stinger000/RaceMini_docs/docs/index.md

# Сборка гоночного дрона COEX Race Mini

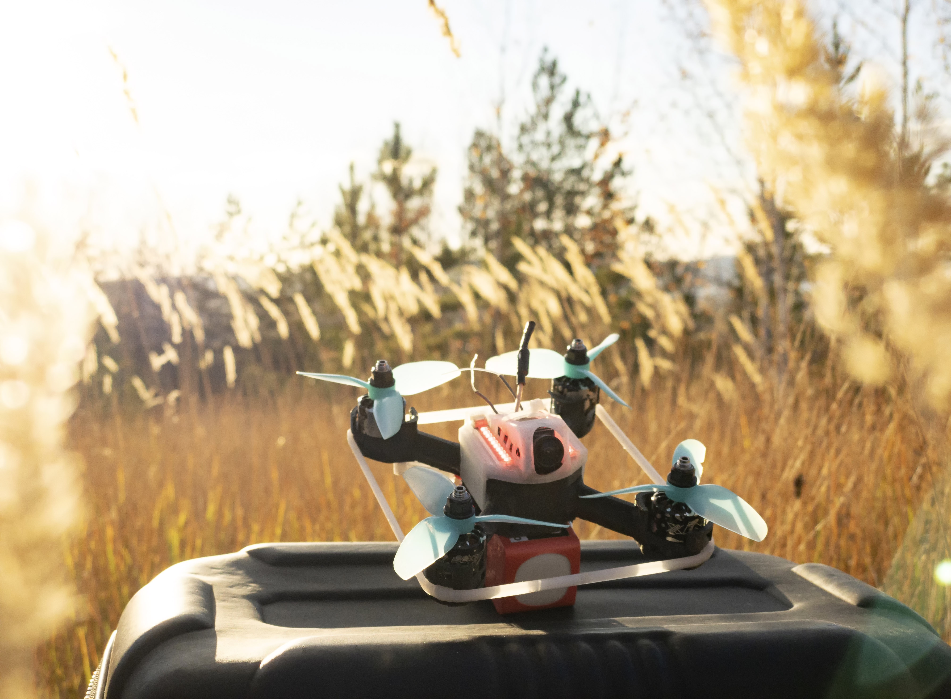
[picture p1: docs/img/drone.jpg]


COEX Race Mini - дрон который предназначен для гонок! При помощи него вы с легкостью освоите спортивное пилотирование.
Тренируйтесь и побеждайте! Увидимся на соревнованиях

## Комплект поставки
Внешний вид коробки:
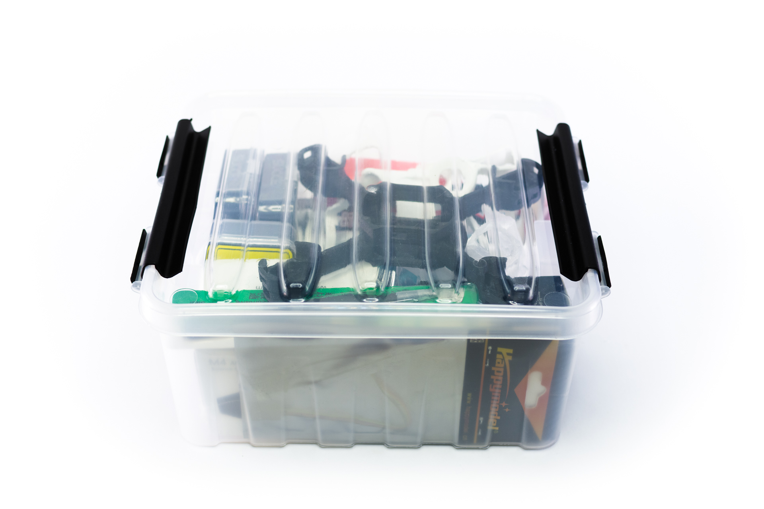
[picture p2: docs/img/box.jpg]

Содержимое:
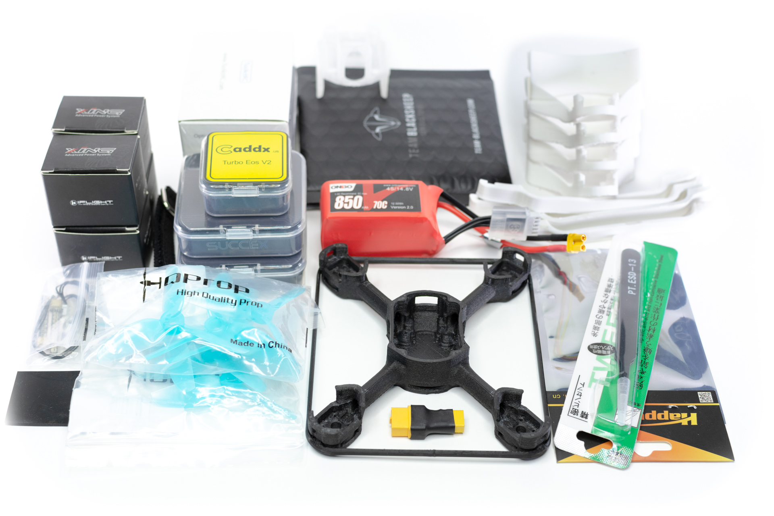
[picture p3: docs/img/box_content.jpg]


## Установка моторов
Установите ребро жесткости на раму, как это показано на видео:
<video src="video/hack.mp4" controls width="100%" ></video>
Изначально моторы поставляются с проводами одинаковой длины и гайками правого вращения:
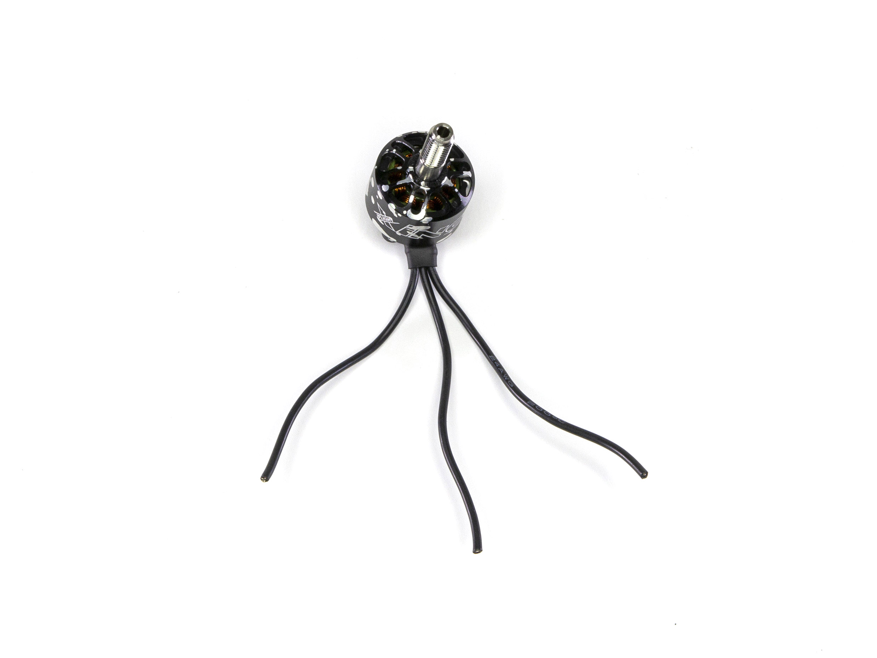
[picture p4: docs/img/motor.jpg]

Два мотора (они будут вращаться по часовой стрелке) обрежьте как показано на рисунке: нижний провод должен быть длиной 60 миллиметров, обозначим его буквой <span style="color:lime">А</span>; средний провод должен быть длиной 65 миллиметров, обозначим его буквой <span style="color:blue">В</span>; верхний провод должен быть длиной 70 миллиметров, обозначим его буквой <span style="color:red">С</span>.
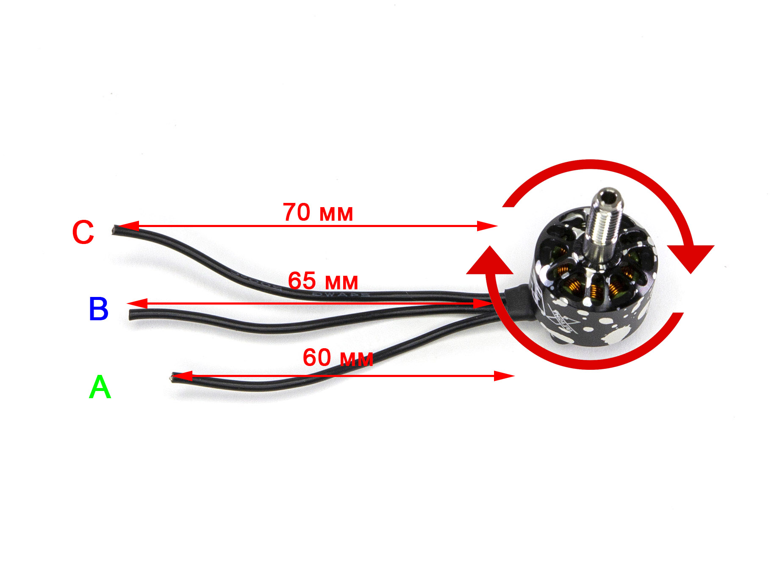
[picture p5: docs/img/motor_cut_cw.jpg]

Другие два мотора (они будут вращаться против часовой стрелки) обрежьте как показано на другом рисунке:
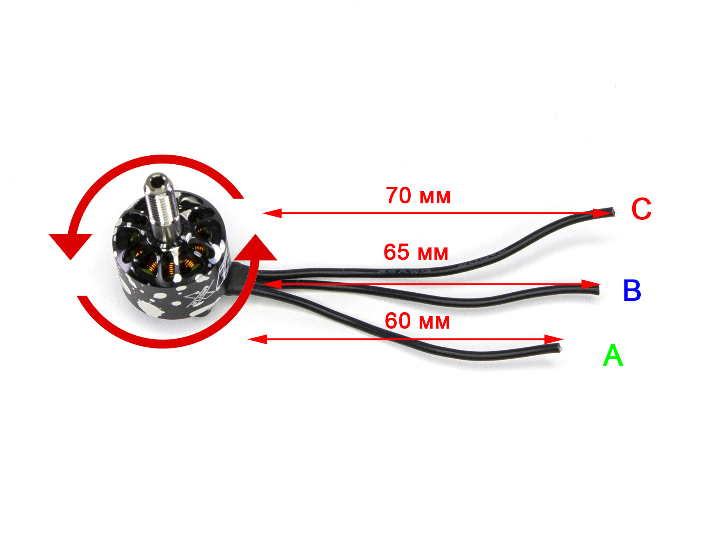
[picture p6: docs/img/motor_cut_ccw.jpg]

Снимите 3 миллиметра изоляции с каждого провода и залудите их. Расположение моторов на дроне будет следующим: моторы, вращающиеся против часовой стрелки находятся на местах 1 и 4, моторы, вращающиеся по часовой стрелке располагаются на местах 2 и 3. На данном рисунке направление переда рамы обозначено стрелкой.
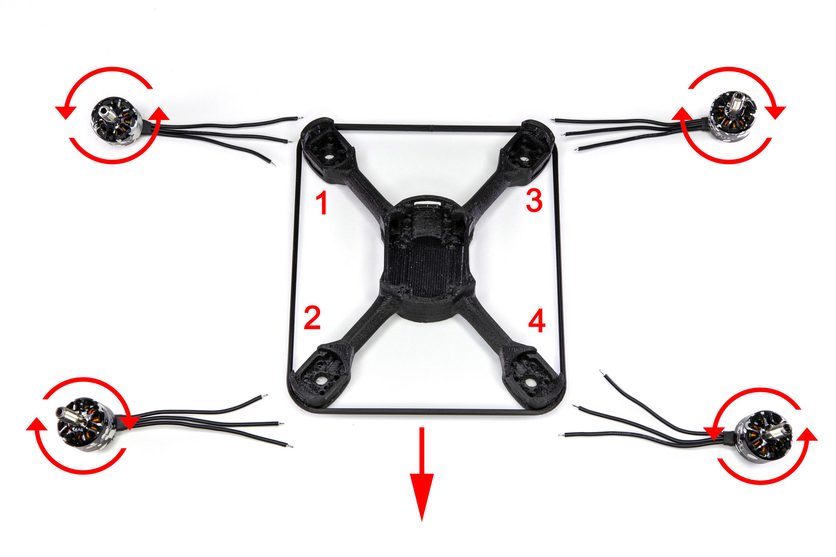
[picture p7: docs/img/motors_tined.jpg]

Установите моторы на места и закрепите с обратной стороны рамы, используя винты М2 из набора моторов:
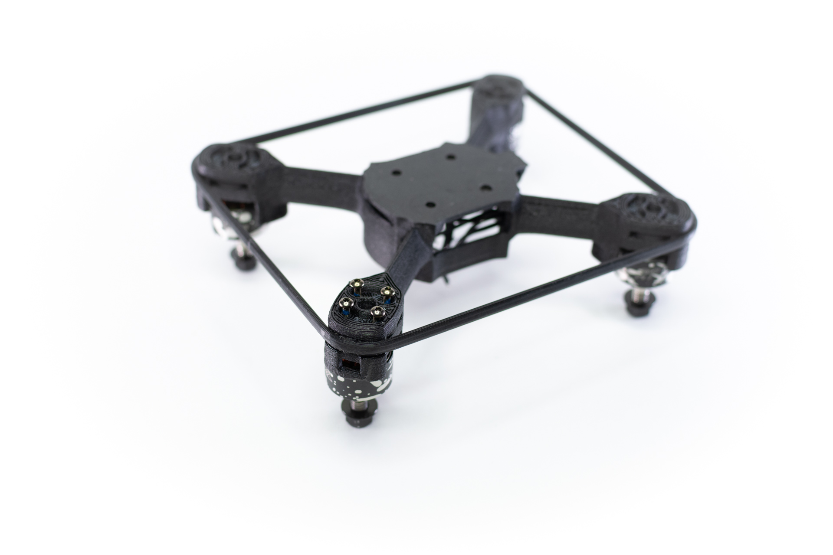
[picture p8: docs/img/motors_bolts.jpg]

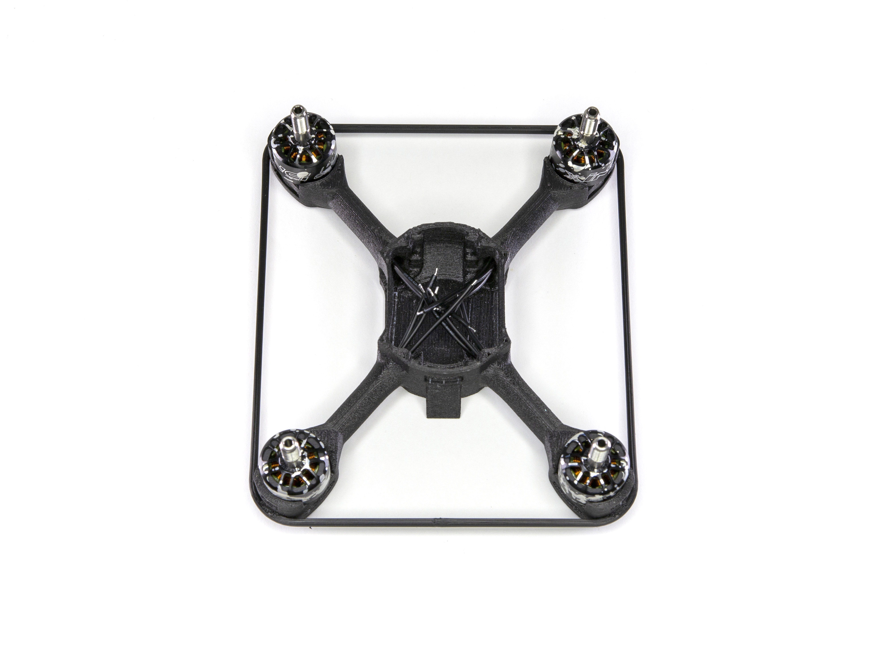
[picture p9: docs/img/motors_mounted.jpg]


## Установка ESC
Внешний вид ESC и кабеля питания:
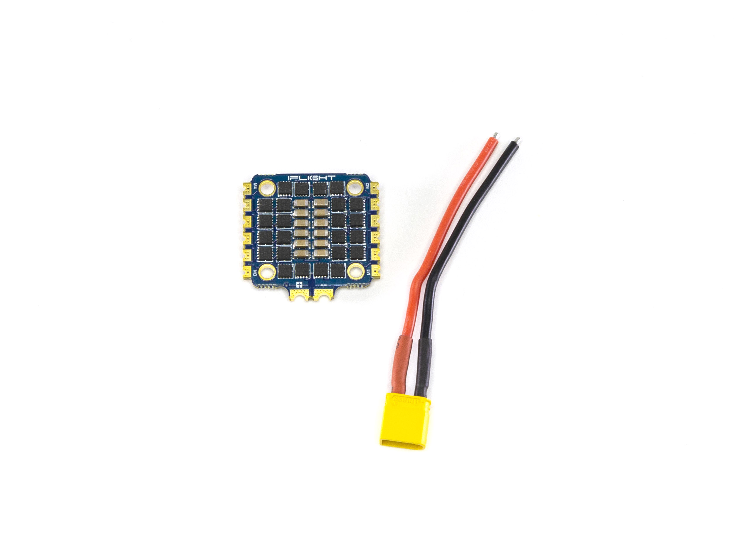
[picture p10: docs/img/esc.jpg]

Обрежьте кабель питания до длины в 20 миллиметров:
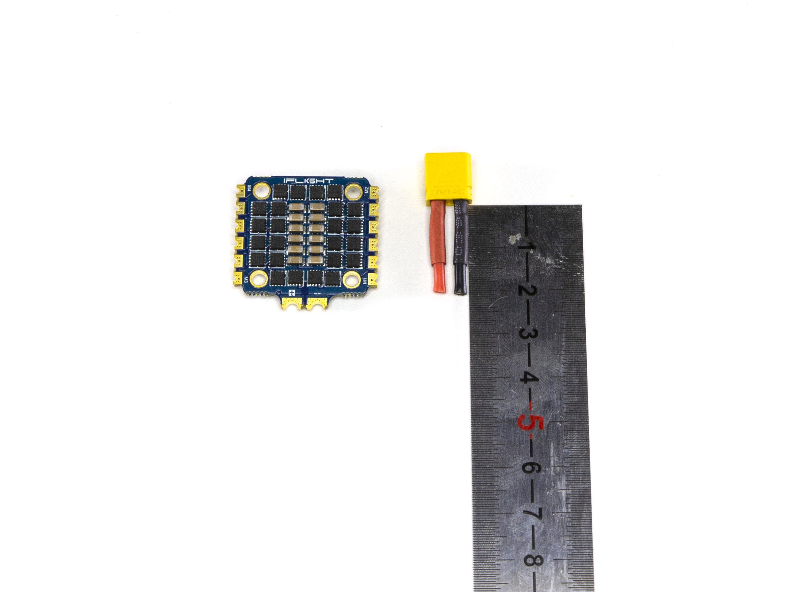
[picture p11: docs/img/esc_cut.jpg]

Снимите три миллиметра изоляции и залудите провода:
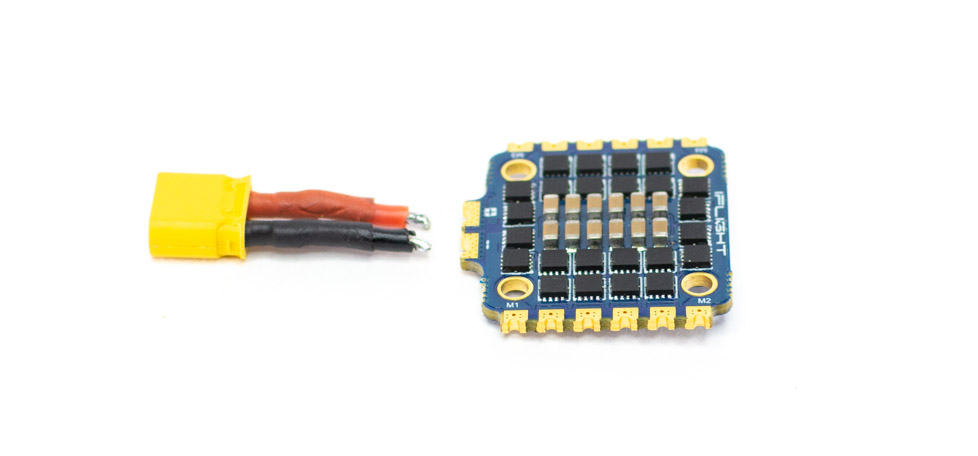
[picture p12: docs/img/esc_tined.jpg]

 Припаяйте их к плате, соблюдая полярность: красный провод необходимо подключить к контакту, обозначенному знаком +, а черный - к контакту, обозначенному знаком - :
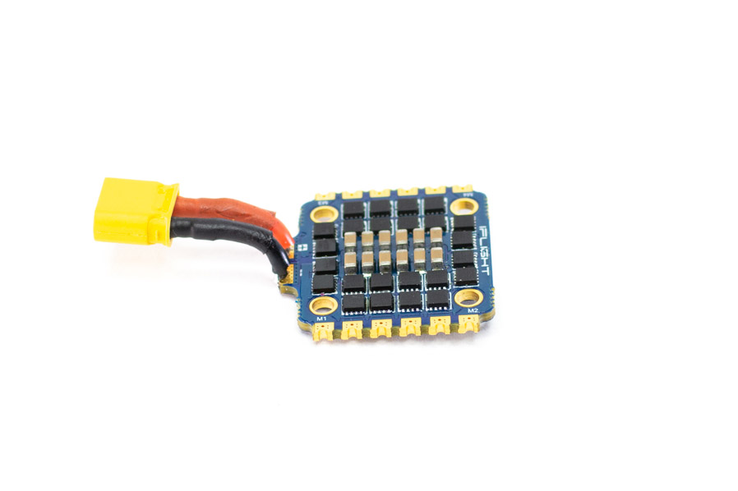
[picture p13: docs/img/esc_soldered.jpg]

Установите силиконовые проставки в отверстия:
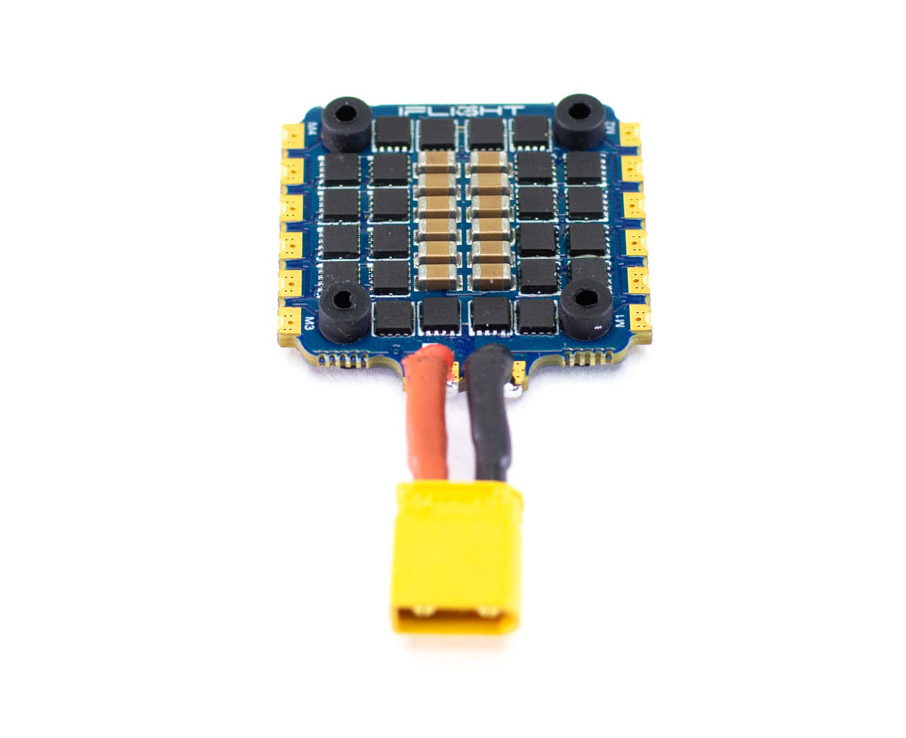
[picture p14: docs/img/esc_orings.jpg]

Более длинная часть должна быть направлена вверх:
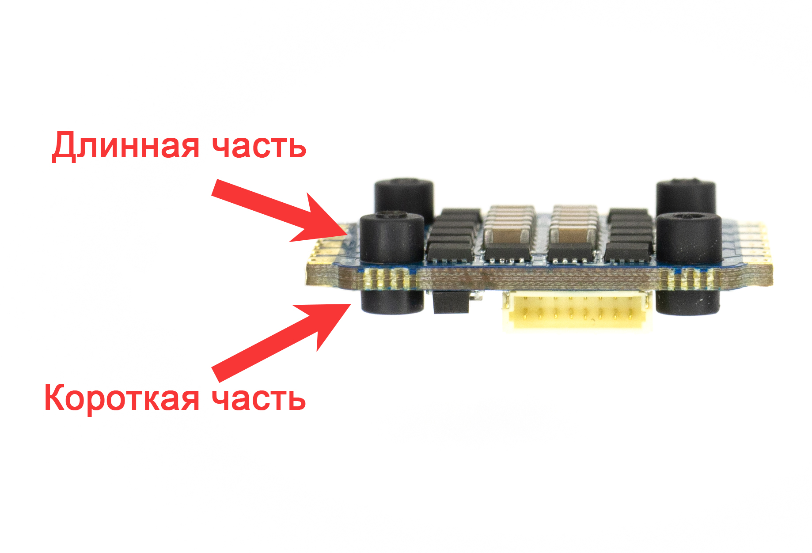
[picture p15: docs/img/esc_orings_pos.jpg]

Вставьте шлейф в плату регуляторов:
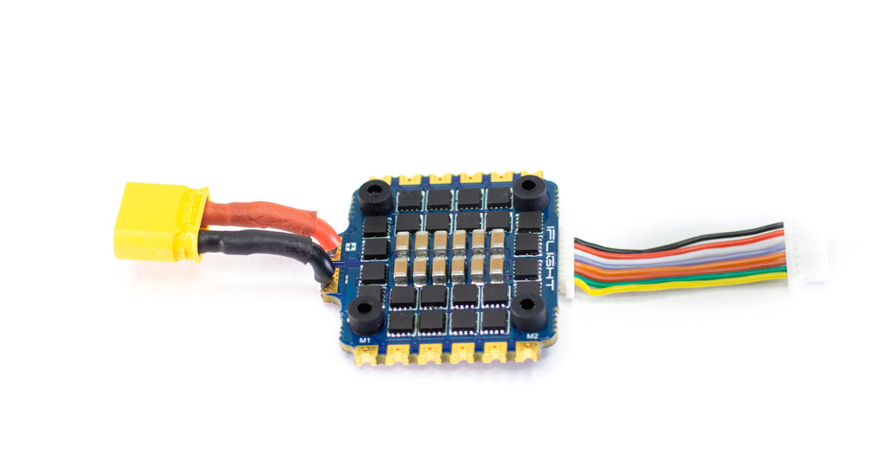
[picture p16: docs/img/esc_cable.jpg]

Установите плату регуляторов со шлейфом в корпус, закрутите винтами М2x20 с обратной стороны.
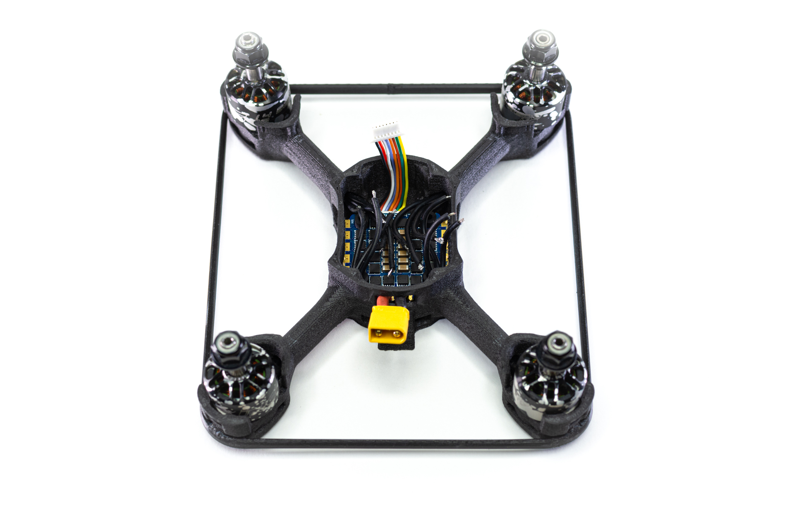
[picture p17: docs/img/esc_placed.jpg]

Припаяйте выводы моторов к контактным площадкам: на рисунке ниже буква
 <span style="color:lime">А</span>
 соответствует короткому проводу, буква
 <span style="color:blue">В</span> -
 среднему, а буква
 <span style="color:red">С</span> -
 длинному проводу.
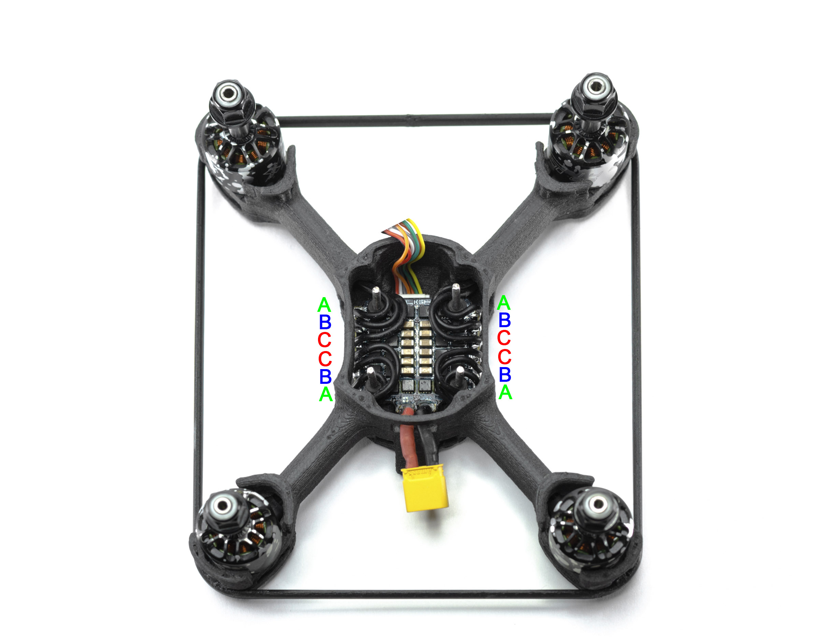
[picture p18: docs/img/esc_motors.jpg]

Вид сбоку:
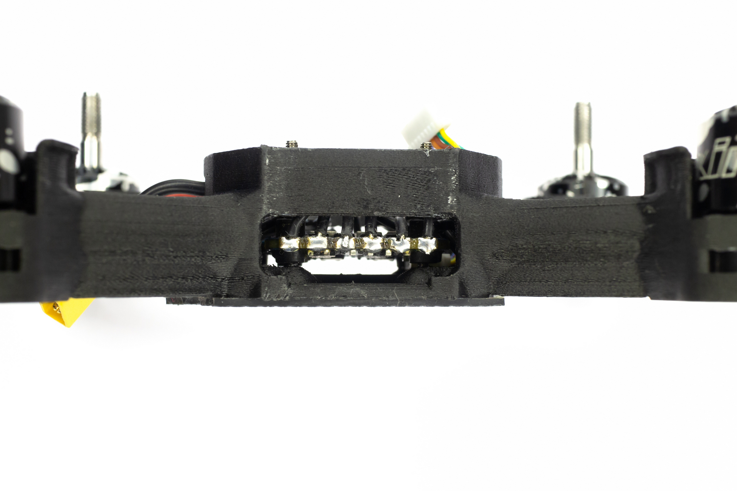
[picture p19: docs/img/esc_side.jpg]


## Установка полетного контроллера

Внешний вид полетного контроллера:
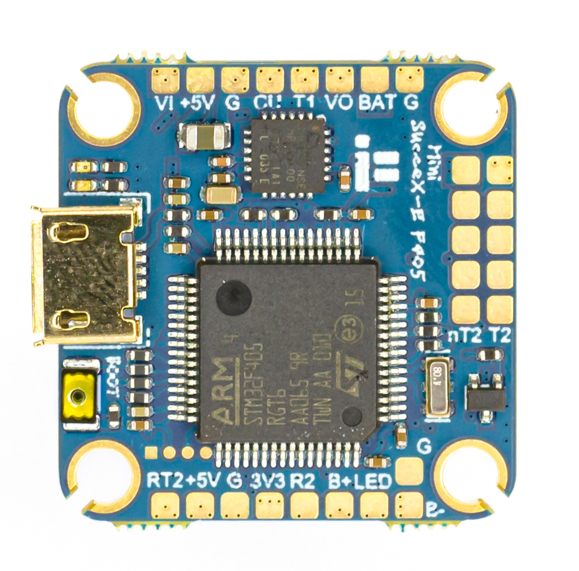
[picture p20: docs/img/fc.jpg]


### Подключение видеопередатчика
Для видеопередатчика IFlight воспользуйтесь данной инструкцией. Если в комплекте с дроном идет видеопередатчик Mamba, то 
шаги инструкции будут те же, но расположение выводов видеопередатчика будет отличаться:

<details>
  <summary>Подключение Mamba VTX</summary>
Данный видеопередатчик имеет следующее расположение выводов:
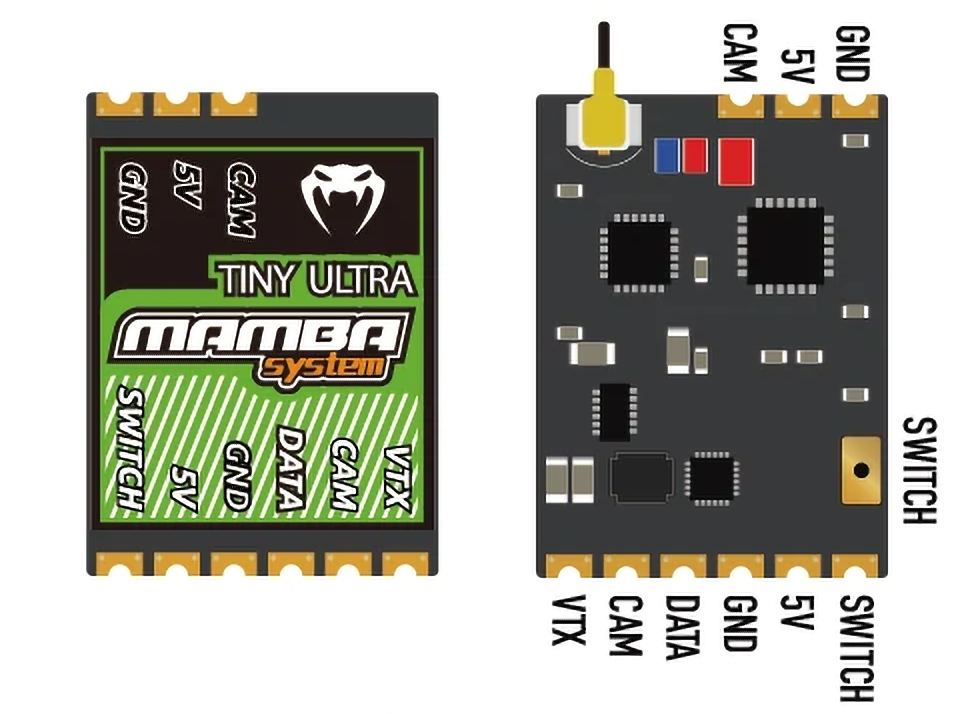
[picture p21: docs/img/vtx_mamba.png]
 
Он подключается в следующей последовательности:
   <table>
        <tr><th>VTX</th><th>Полетный контроллер</th></tr>
        <tr>
             <td>
                  <font color=red>5V</font>
             </td>
             <td>5v</td>
        </tr>
        <tr>
             <td><font color=black>GND</font></td>
             <td>G</td>
        </tr>
        <tr>
             <td><font color=goldenrod>VTX</font></td>
             <td>VO</td>
        </tr>
        <tr>
             <td><font class="outlined">DATA</font> </td>
             <td>T1</td>
        </tr>
   </table>

</details>

Видеопередатчик находится внутри этой коробочки:
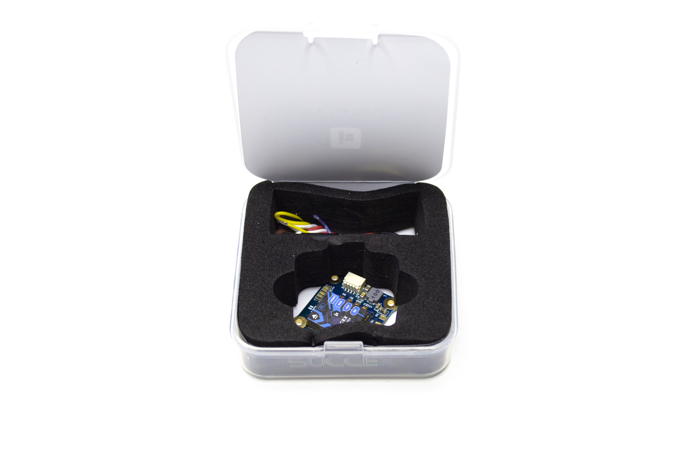
[picture p22: docs/img/vtx_pack.jpg]

Внутри находится сам видеопередатчик, адаптер для установки в отверстия 20х20 (он нам не понадобится), антенна, переходник для установки другой антенны (он также не понадобится) и провода:
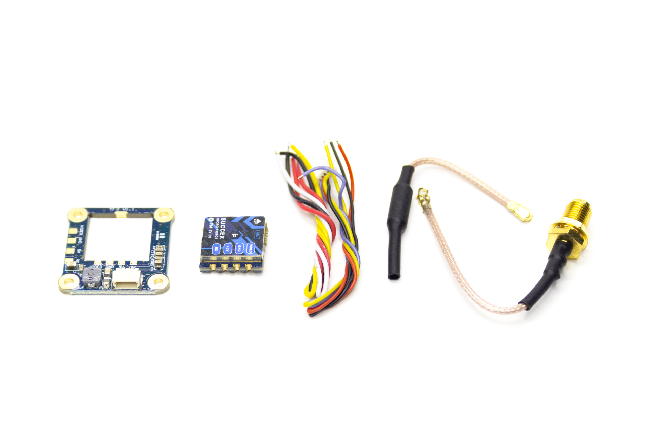
[picture p23: docs/img/vtx_pack_content.jpg]

На верхней стороне видеопередатчика находятся подписи контактных площадок:
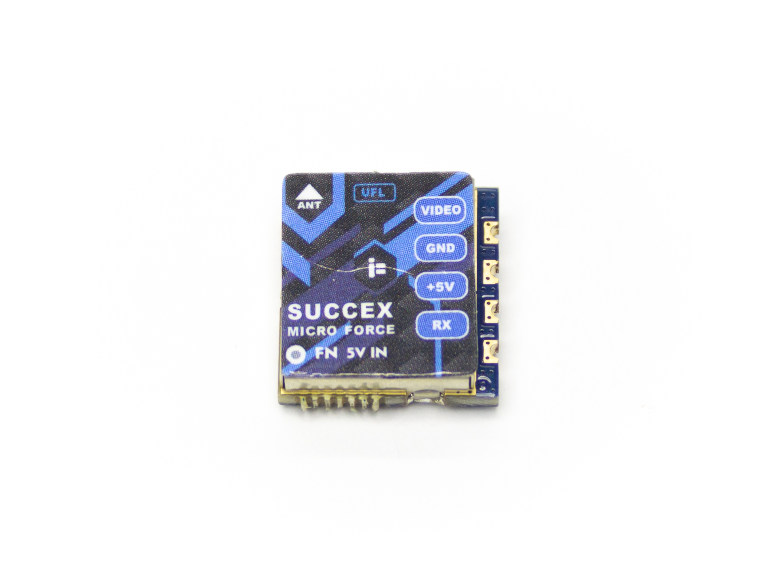
[picture p24: docs/img/vtx_top.jpg]

С другой стороны располагается разъем для антенны и кнопка переключения каналов:
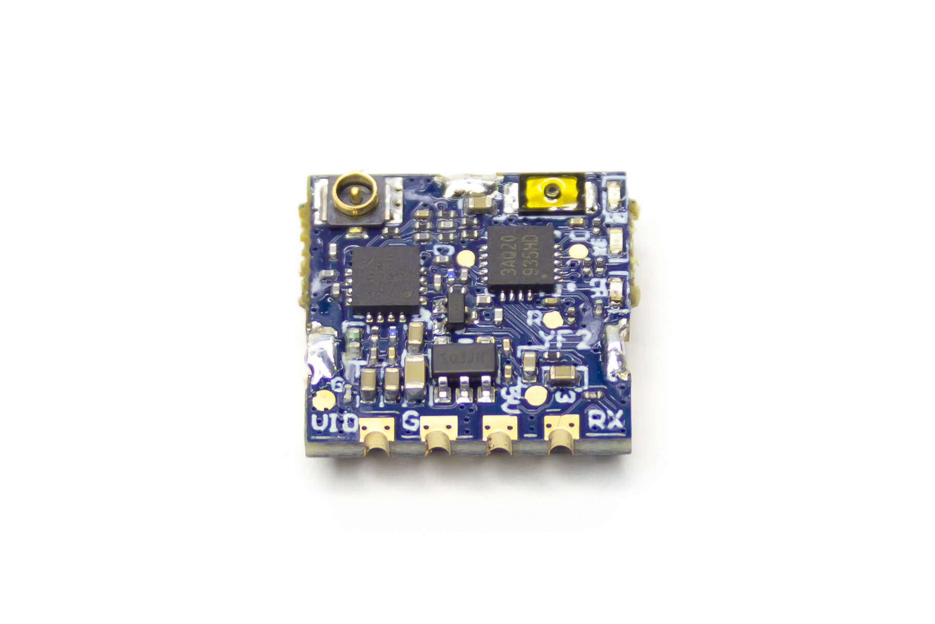
[picture p25: docs/img/vtx_bottom.jpg]

Припаяйте провода к видеопередатчику в следующей последовательности:
<span style="color:red">красный</span>
провод к контакту +5V, **черный** - к контакту GND,
<span style="color:goldenrod;">желтый</span> - к контакту VIDEO и
<span class="outlined">белый</span> - к контакту RX:
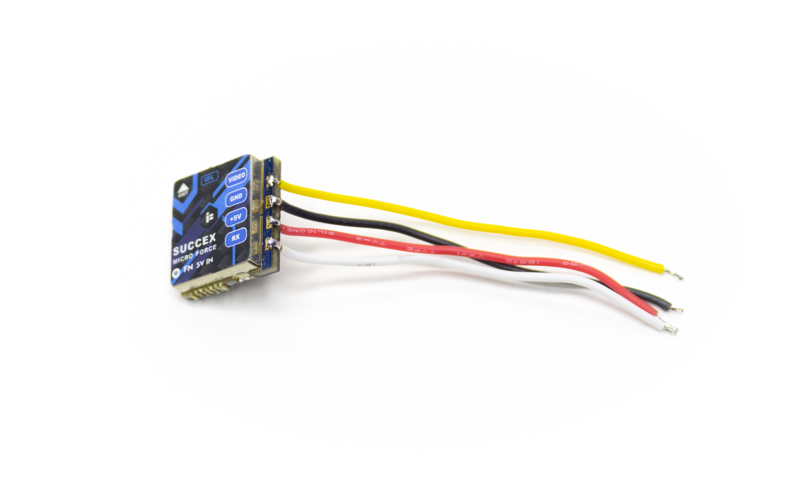
[picture p26: docs/img/vtx_cable.jpg]

Вставите антенну в видеопередатчик:
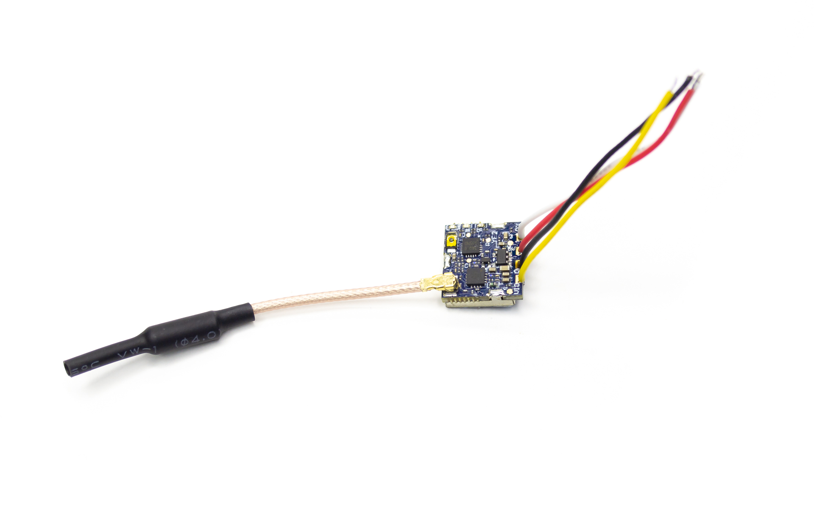
[picture p27: docs/img/vtx_antenna.jpg]

Наденьте термоусадку на видеопередатчик и усадите её потоком горячего воздуха:
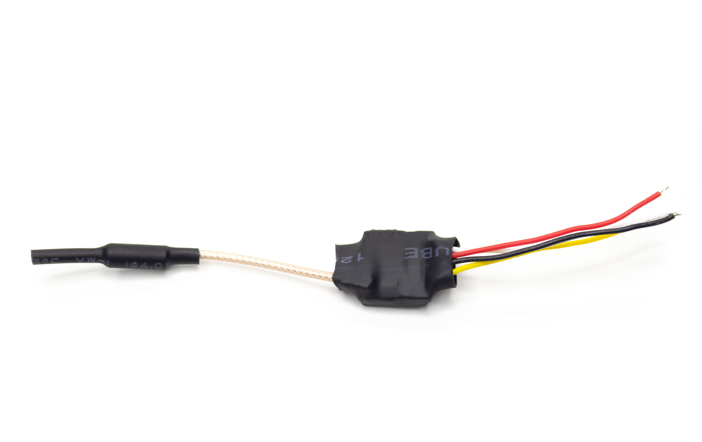
[picture p28: docs/img/vtx_heatshrink.jpg]

Обрежьте провода до длины в 60 миллиметров, залудите на 3 миллиметра и припаяйте провода к полетному контроллеру в следующей последовательности:
<span style="color:red">красный</span>
провод к контакту +5V, **черный** - к контакту G,
<span style="color:goldenrod;">желтый</span> - к контакту VO и
<span class="outlined">белый</span> - к контакту T1:
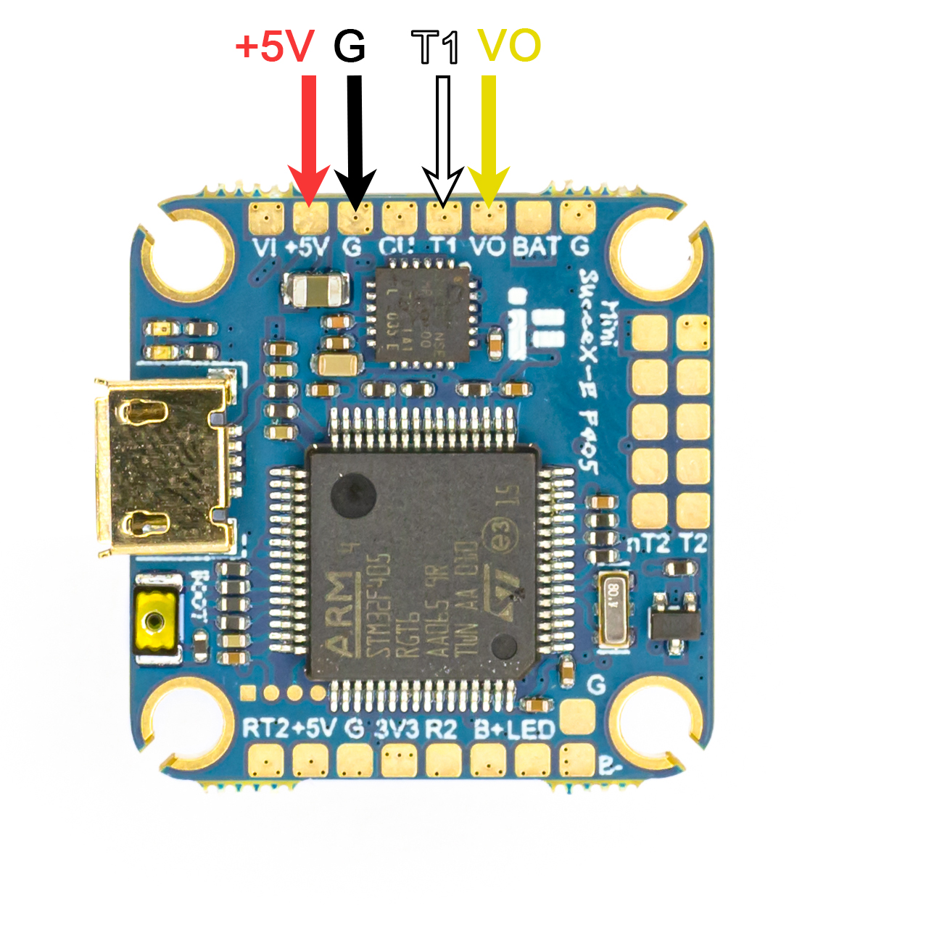
[picture p29: docs/img/vtx_pads.jpg]

Вот так это будет выглядеть:
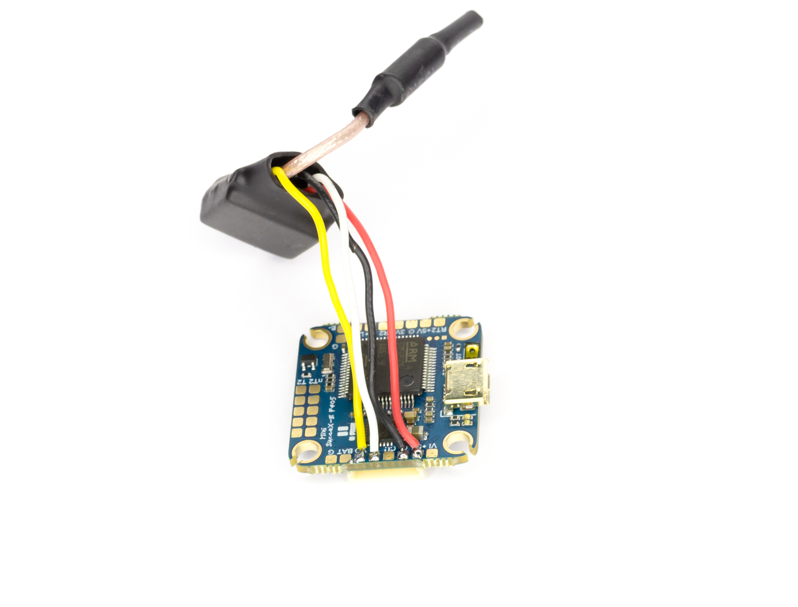
[picture p30: docs/img/vtx_soldered.jpg]


### Подключение камеры

Внешний вид камеры:
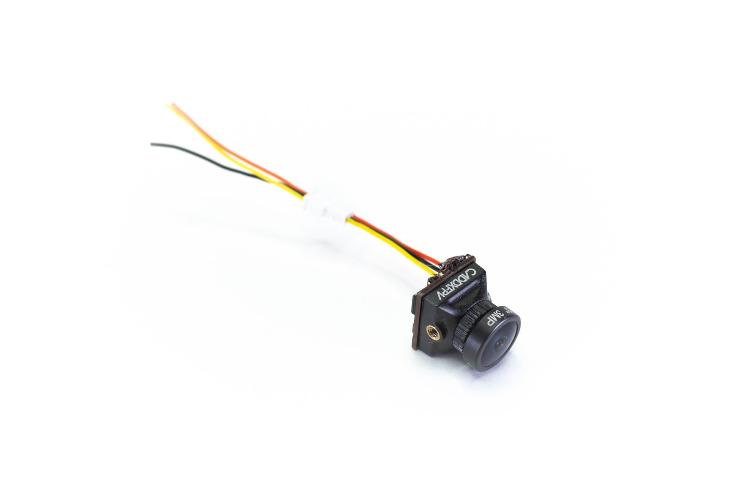
[picture p31: docs/img/cam.jpg]

Обрежьте ответный кабель разъема камеры на длину в 50 миллиметров, и залудите концы на длину в 3 миллиметра. Припаяйте его к полетному контроллеру в следующем порядке:
**черный** провод - к контакту G,
<span style="color:goldenrod;">желтый</span> - к контакту VI,
<span style="color:red">красный</span> - к контакту +5 вольт, как показано на схеме:
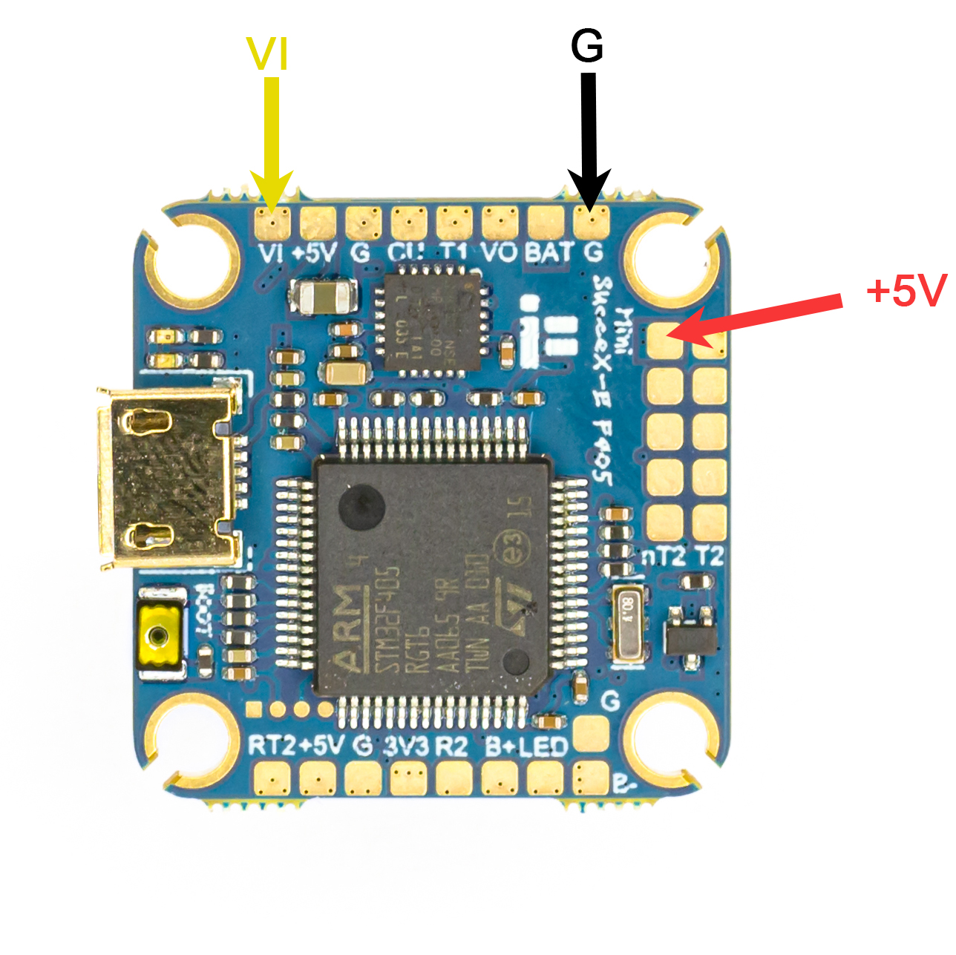
[picture p32: docs/img/cam_pads.jpg]

Припаянный провод должен выглядеть следующим образом:
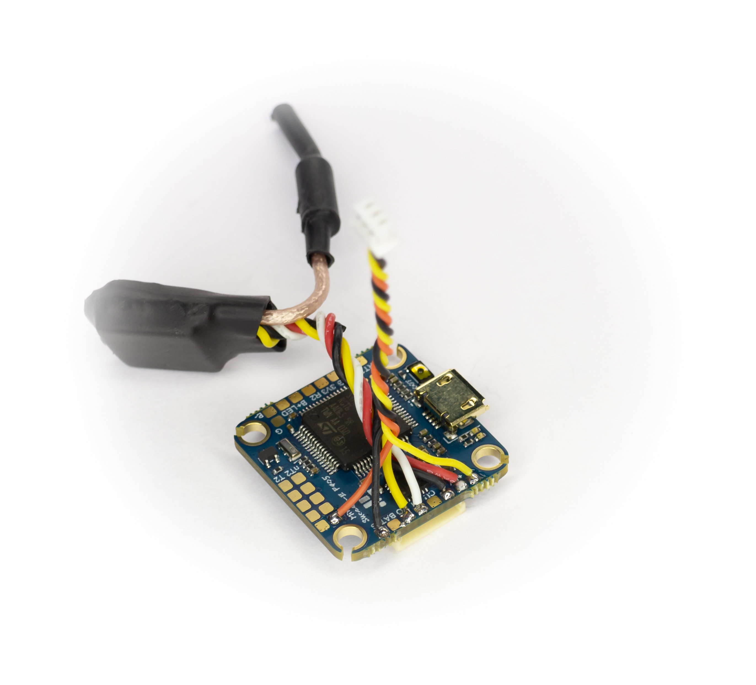
[picture p33: docs/img/cam_cable_soldered.jpg]


### Подключение светодиодной ленты

В комплекте со светодиодной лентой идет провод:
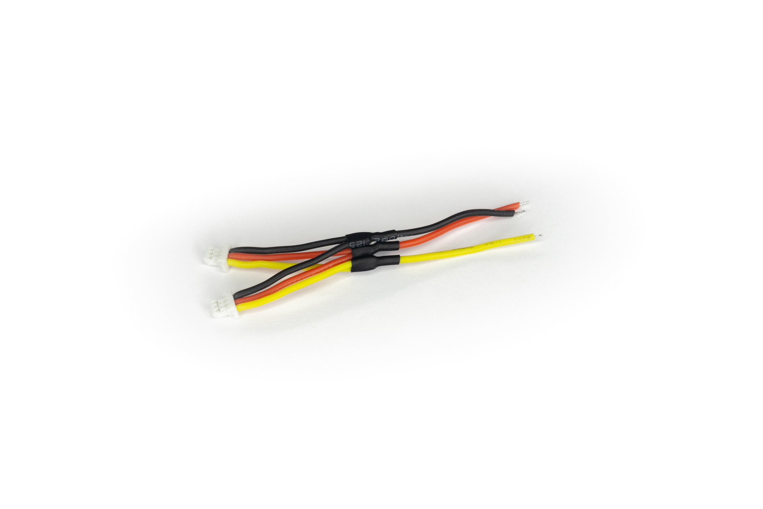
[picture p34: docs/img/led_cable.jpg]

Припаяйте провода к полетному контроллеру в следующей последовательности:
**G** к контакту G,
<span style="color:red">5v</span> к контакту B+ полетного контроллера, и
<span style="color:goldenrod;">sig</span> к контакту LED, как показано на схеме:
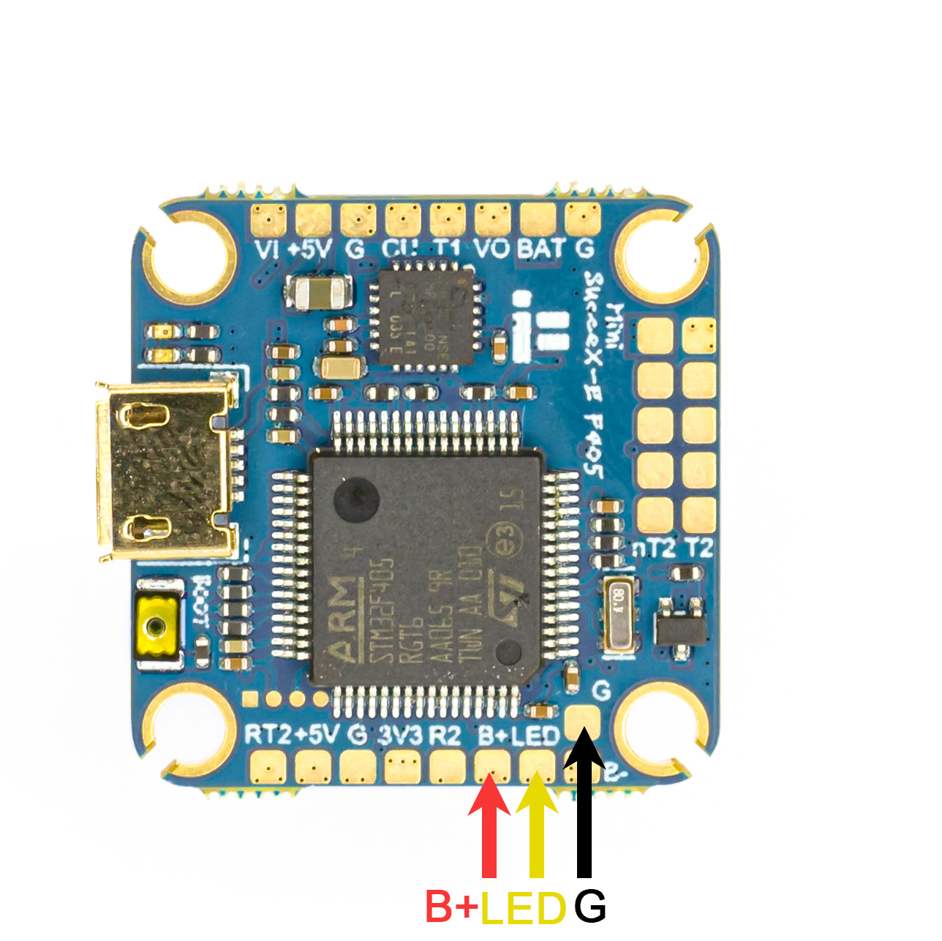
[picture p35: docs/img/led_pads.jpg]

Припаянный провод должен выглядеть следующим образом:
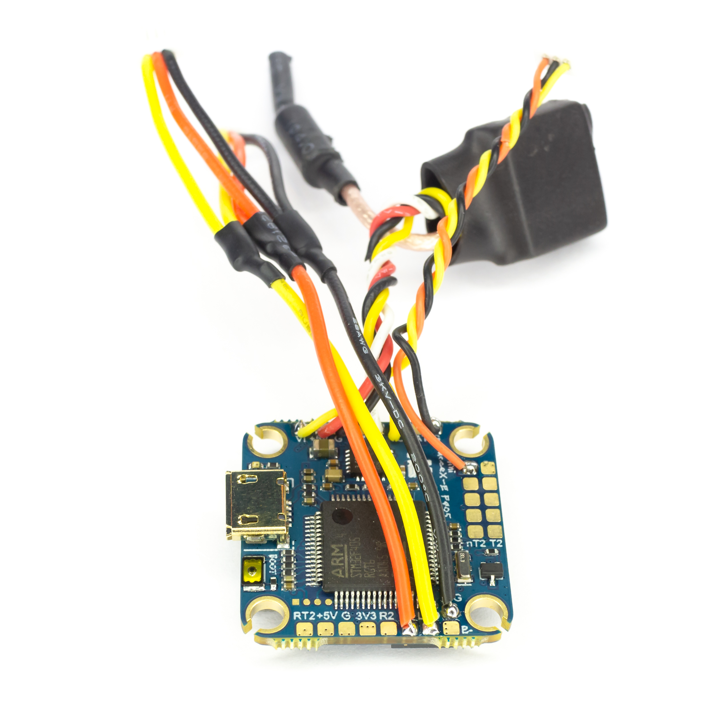
[picture p36: docs/img/led_soldered.jpg]


### Подключение радиоприемника

Внешний вид радиоприемника:
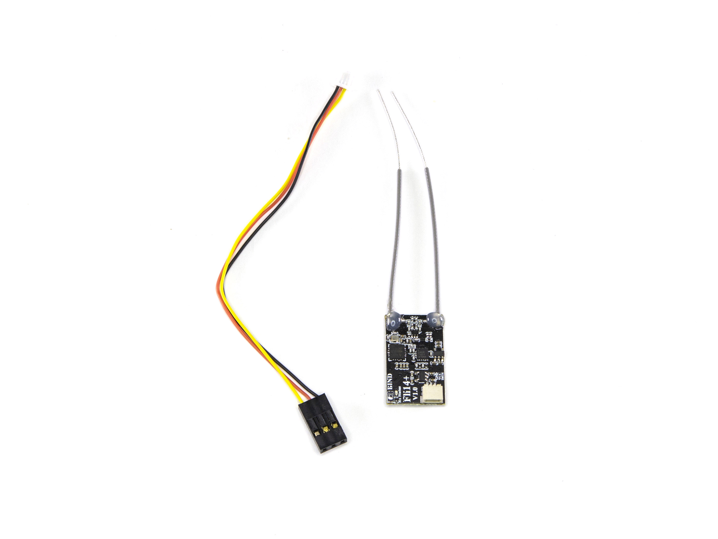
[picture p37: docs/img/rc.jpg]

Обрежьте провода приемника на длину 50 миллиметров и залудите концы на длину 3 миллиметра. Припаяйте провода к полетному контроллеру в следующем порядке:
<span style="color:red">красный</span>
провод к контакту +5V, **черный** - к контакту G,
<span style="color:goldenrod;">желтый</span> - к контакту R2, как показано на рисунке:
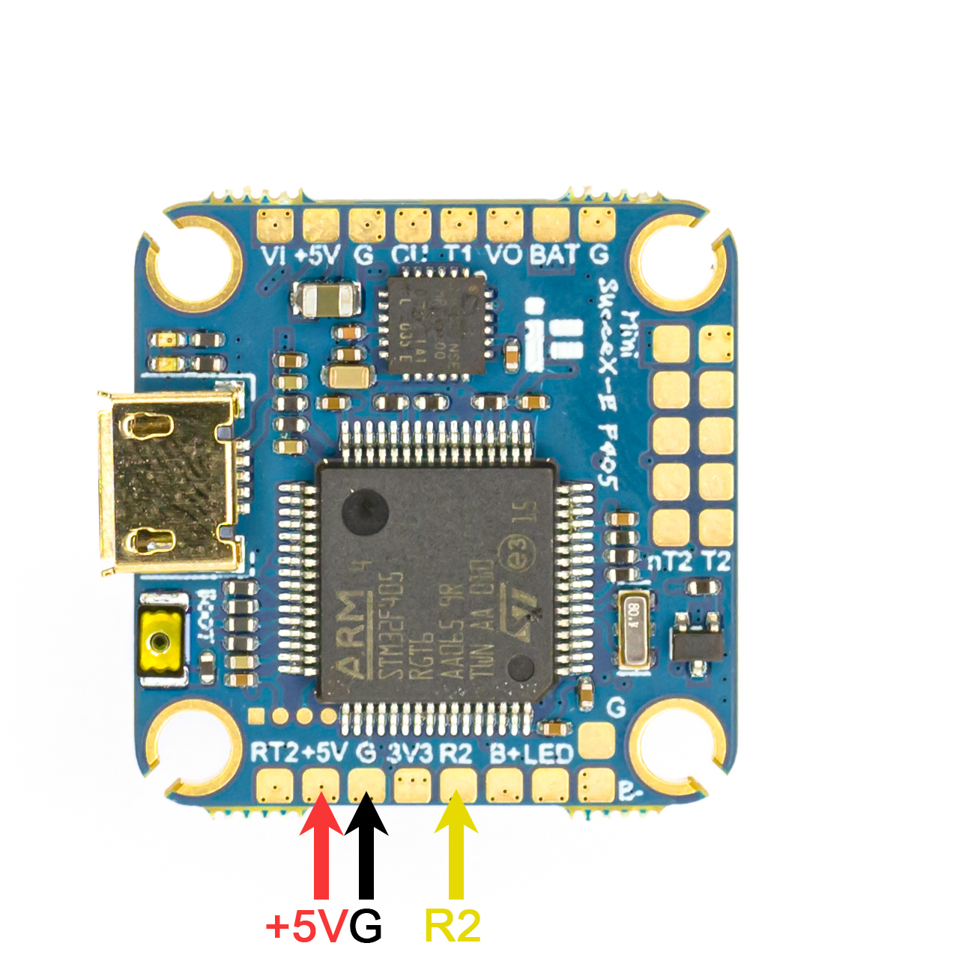
[picture p38: docs/img/rc_pads.jpg]

Припаянный провод должен выглядеть следующим образом:
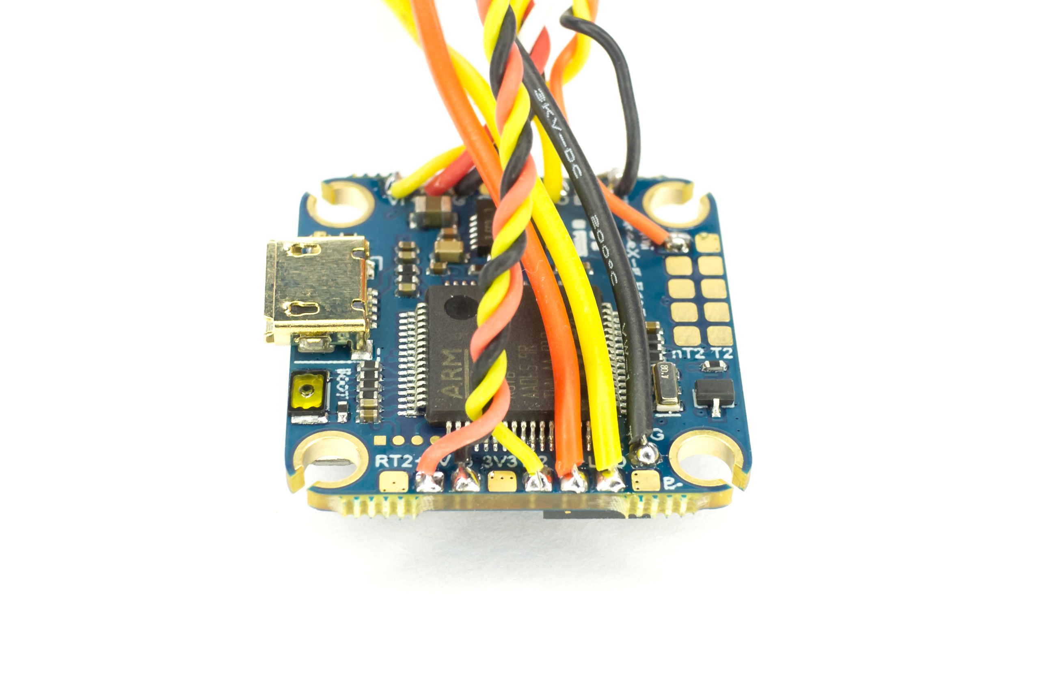
[picture p39: docs/img/rc_cable.jpg]

Наденьте термоусадку на радиоприемник и усадите:
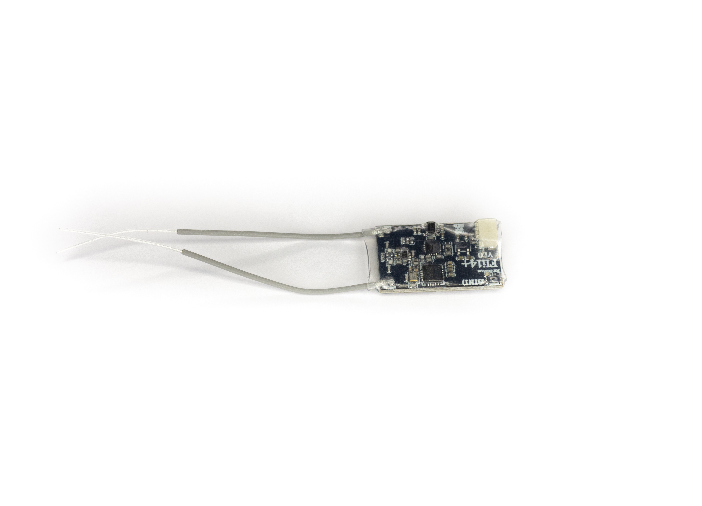
[picture p40: docs/img/rc_shrinked.jpg]

После этого подключите приемник к припаянному только что кабелю.

### Установка полетного контроллера в корпус
Вставьте силиконовые проставки в полетный контроллер в соответствие со схемой:
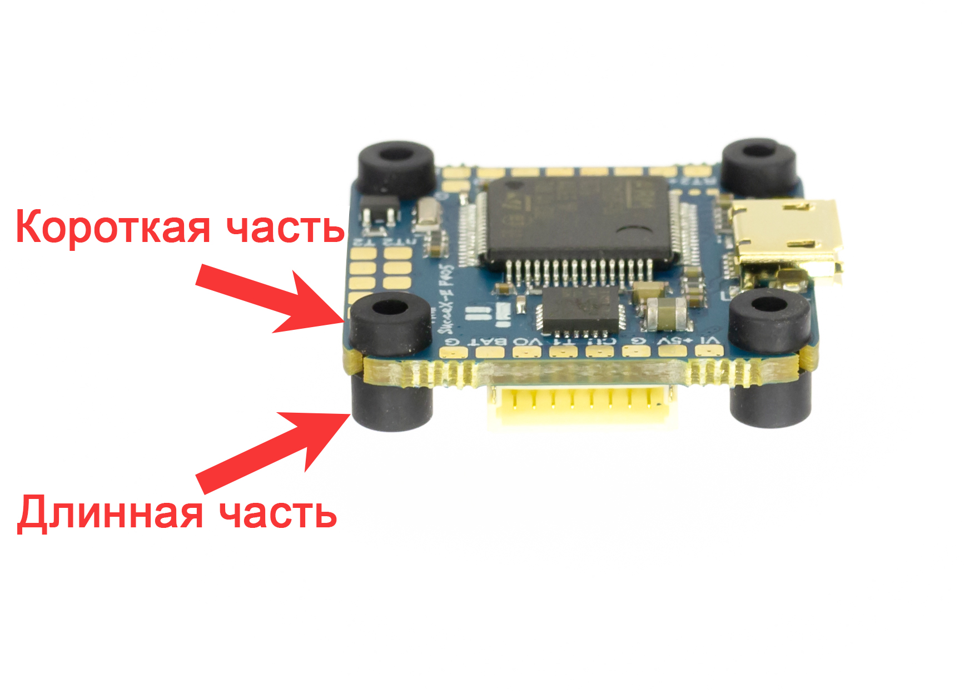
[picture p41: docs/img/fc_orings_pos.jpg]

Подключите шлейф, идущий от регуляторов к полетному контроллеру, установите его в корпус и зафиксируйте гайками:
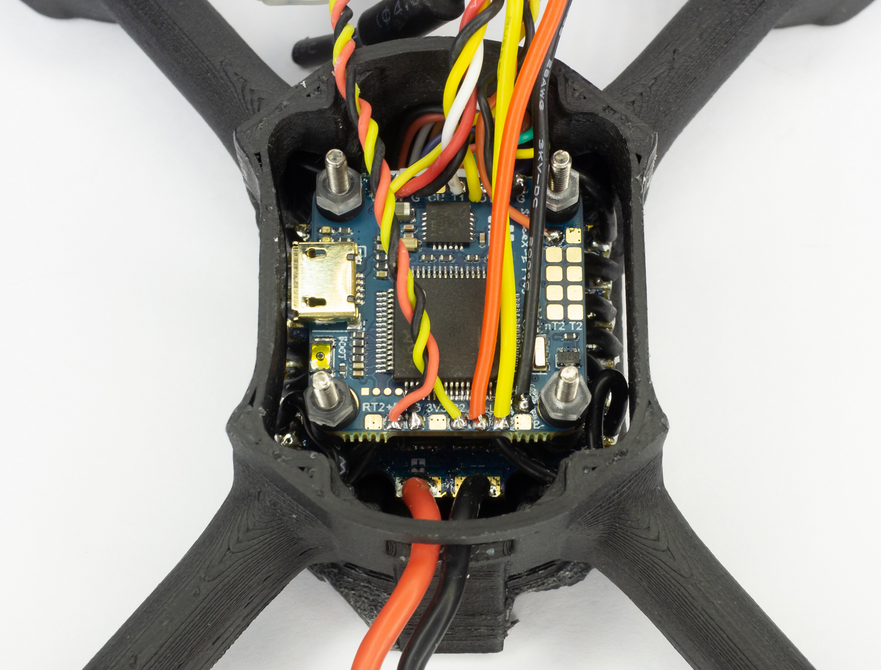
[picture p42: docs/img/fc_nuts.jpg]

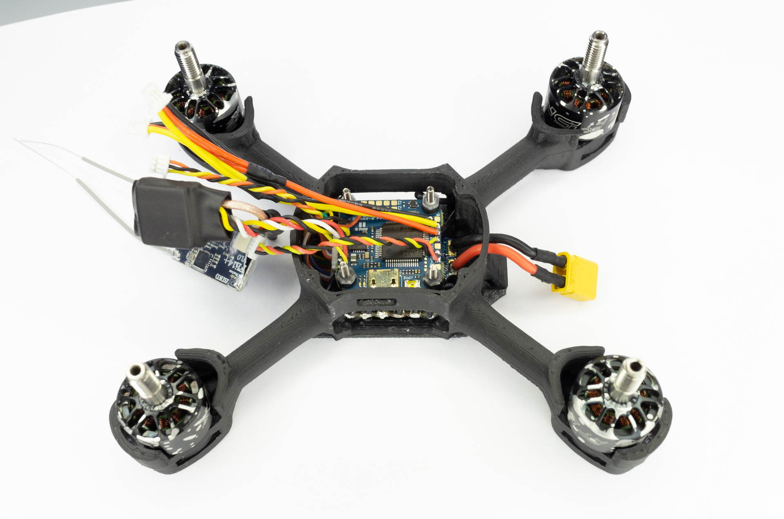
[picture p43: docs/img/fc_placed.jpg]


## Подключение аппаратуры радиоуправления

Если сейчас подключить аккумулятор к дрону, то светодиод на приемнике начнет медленно мигать:
<picture>
   <source srcset="img/rx_unbinded.avif" type="image/avif">
   <source srcset="img/rx_unbinded.webp" type="image/webp">
   описание
</picture>
Это означает, что радиоприемник не получает сигнал от аппаратуры радиоуправления. Такое может происходить в двух случаях:

1. Аппаратура радиоуправления выключена
2. Радиоприемник и аппаратура радиоуправления не настроены для работы друг с другом

Для радиоуправления дроном необходимо настроить радиоприемник на работу с конкретной радиоаппаратурой (данная процедура называется bind). Для этого необходимо при выключенном питании дрона нажать кнопку Bind на радиоприемнике, после чего с зажатой кнопкой подключить аккумулятор. Светодиод на радиоприемнике начнет быстро мигать:
<picture>
   <source srcset="img/rx_binding.avif" type="image/avif">
   <source srcset="img/rx_binding.webp" type="image/webp">
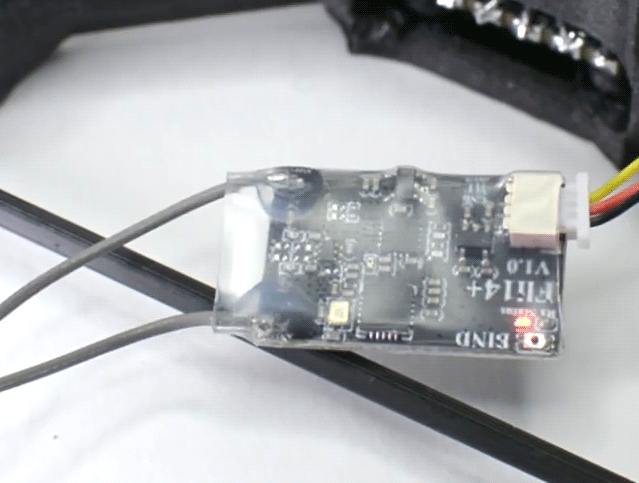
[picture p44: docs/img/rx_binding.gif]
   
</picture>

После этого зажмите кнопку Bind на аппаратуре управления и включите ее:
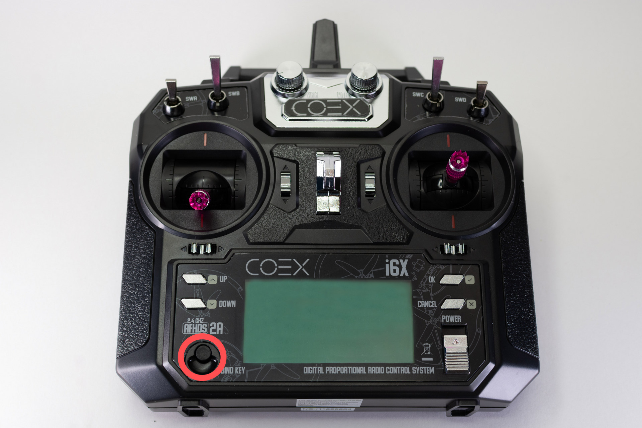
[picture p45: docs/img/app_off.jpg]

В случает успеха светодиод на радиоприемнике будет гореть постоянно:
_image
А на экране аппаратуры радиоуправления будет отображаться напряжение питания приемника:
_image
## Финальная сборка

Внешний вид канопы с камерой:
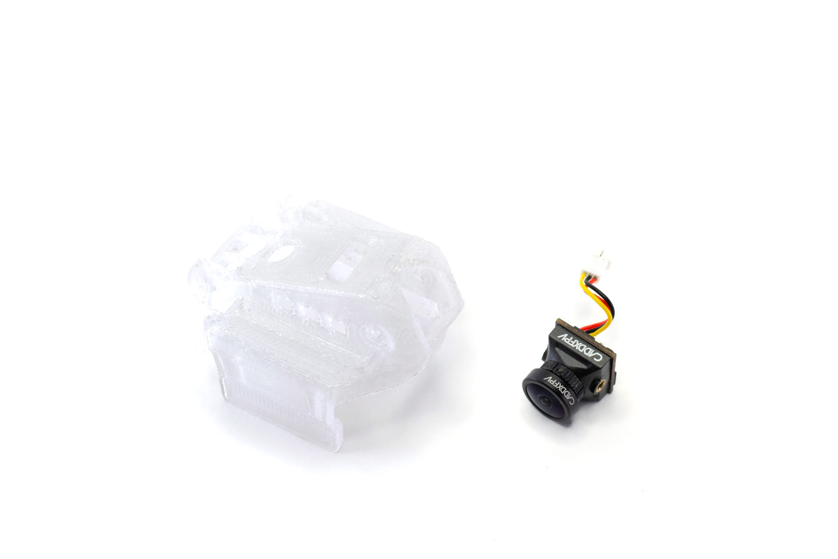
[picture p46: docs/img/final_canopy.jpg]

Установите камеру внутри канопы и зафиксируйте винтами:
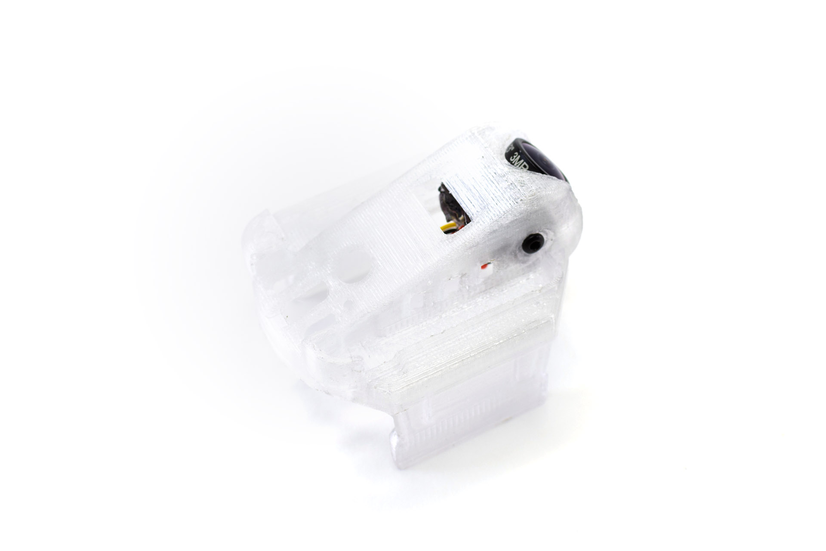
[picture p47: docs/img/final_cam_mounted.jpg]

Подключите камеру к полетному контроллеру. Расположите радиоприемник и видеопередатчик внутри канопы. Проденьте разъемы для светодиодных лент в отверстия канопы и подключите их.
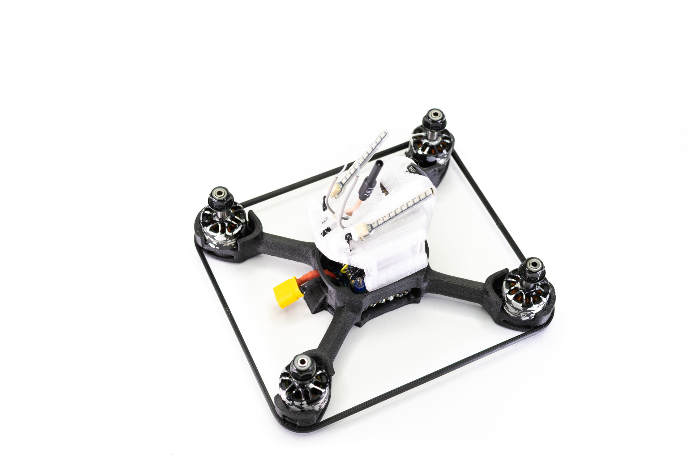
[picture p48: docs/img/final_led.jpg]

Защелкните светодиодные ленты в их посадочных местах:
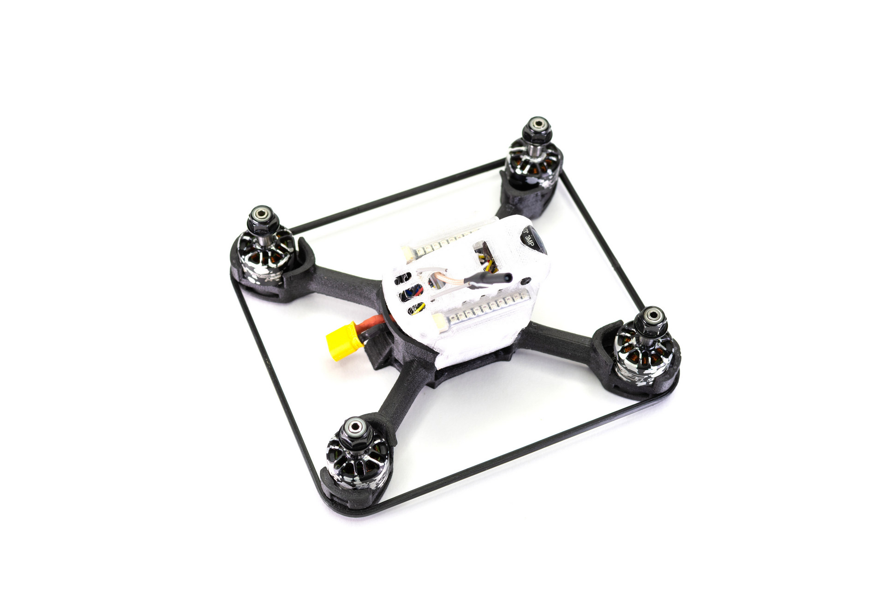
[picture p49: docs/img/final_led_mounted.jpg]

Подключите переходник USB и выполните
[настройку дрона](setup):
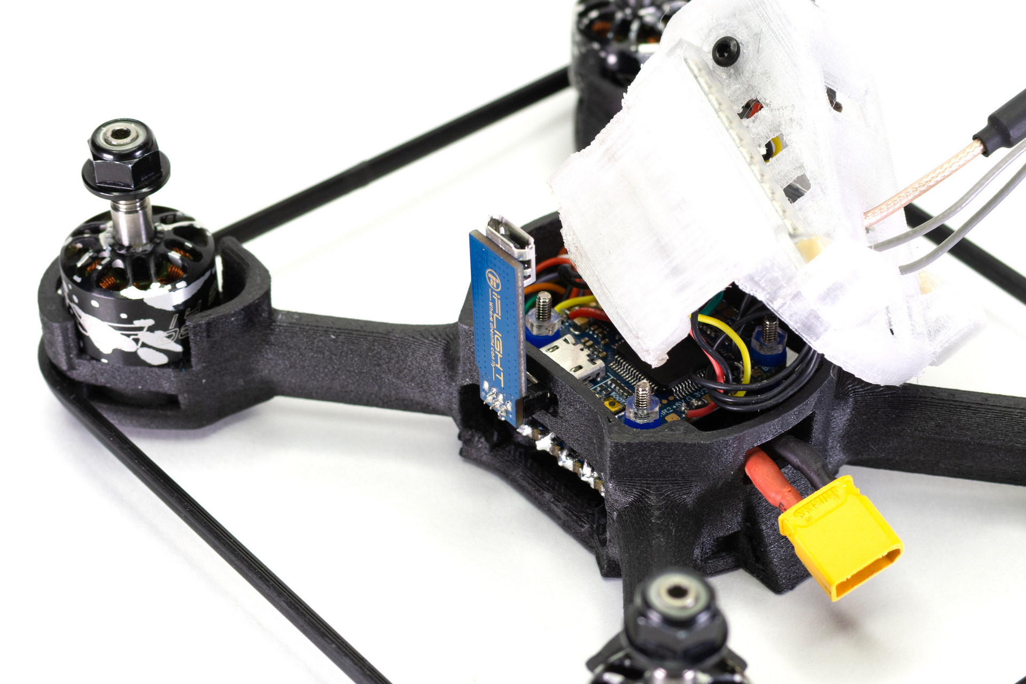
[picture p50: docs/img/final_usb.jpg]

После того, как настройка закончена, защелкните канопу на дроне:
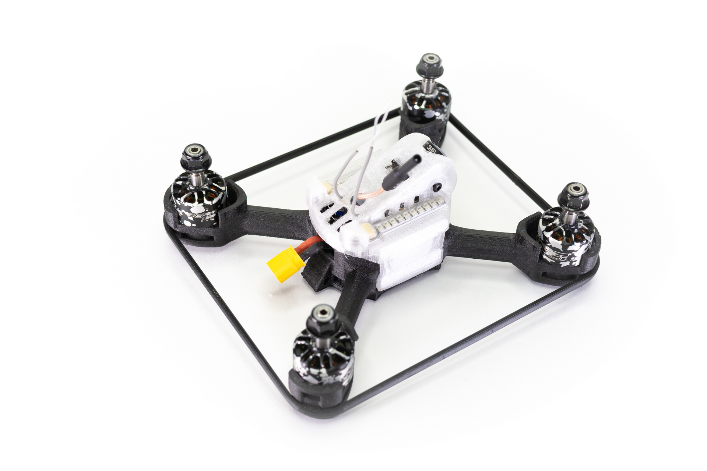
[picture p51: docs/img/final_canopy_locked.jpg]

Переверните дрон нижней стороной вверх:
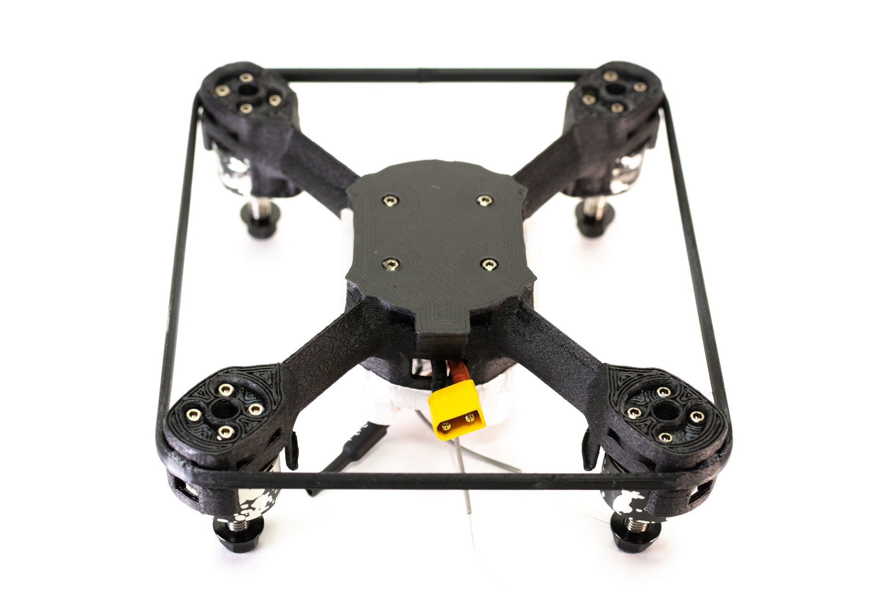
[picture p52: docs/img/final_bottom.jpg]

Наклейте противоскользящую накладку:
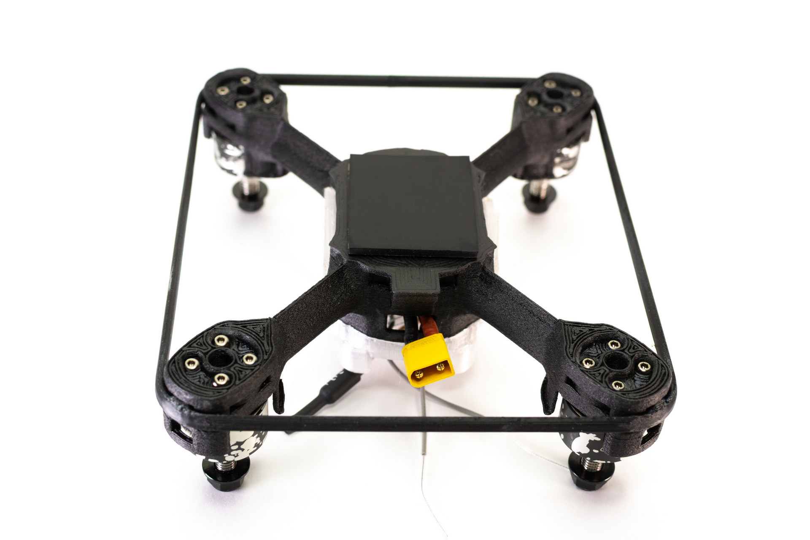
[picture p53: docs/img/final_silicon.jpg]

На этом сборка завершена.
