stinger000/RaceMini_docs/docs/rc.md

# Настройка пульта

Перед настройкой полетного контроллера необходимо выполнить настройку пульта. После того, как вы произвели бинд приемника и пульта, на включенном пульте удерживайте клавишу OK (сам дрон должен быть выключен). Вы попадете в меню:
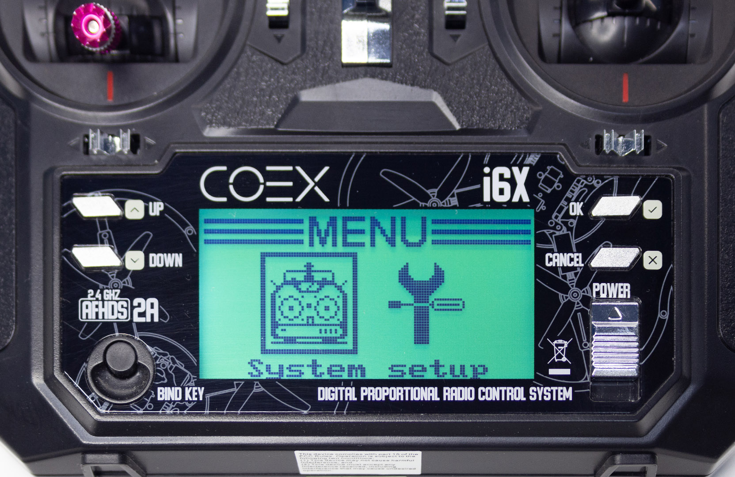
[picture p54: docs/img/rc/rc_system.jpg]

Убедитесь, что подсвечена вкладка System и нажмите OK. Вы попадете в меню системных настроек:
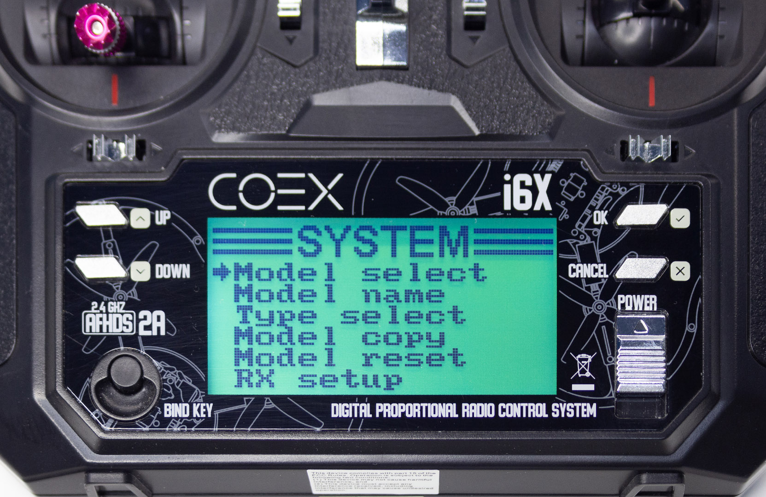
[picture p55: docs/img/rc/rc_system_menu.jpg]

Нажимая на кнопку DOWN пролистайте меню вниз, до пункта Aux switches:
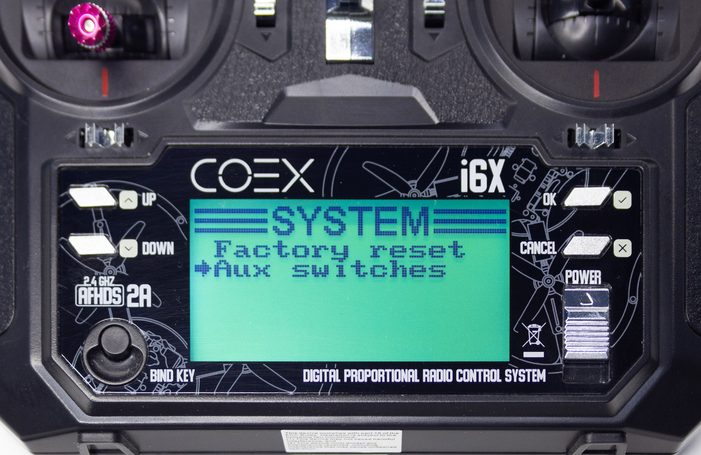
[picture p56: docs/img/rc/rc_system_aux.jpg]

Нажмите OK, вы попадете в раздел настройки дополнительных каналов:
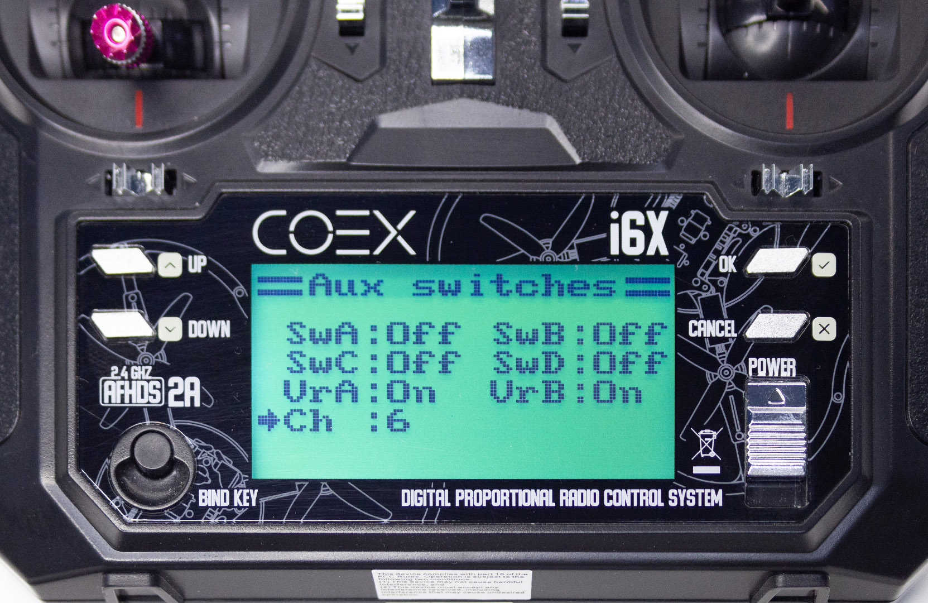
[picture p57: docs/img/rc/rc_aux_6.jpg]

По умолчанию количество каналов равно шести, а все свитчи находятся в положении Off. При помощи кнопки UP настройте все свичи в положение On, также увеличьте количество каналов до 10. Переключение между пунктами меню происходит при помощи клавиши OK. В конечном итоге все настройки должны выглядеть следующим образом:
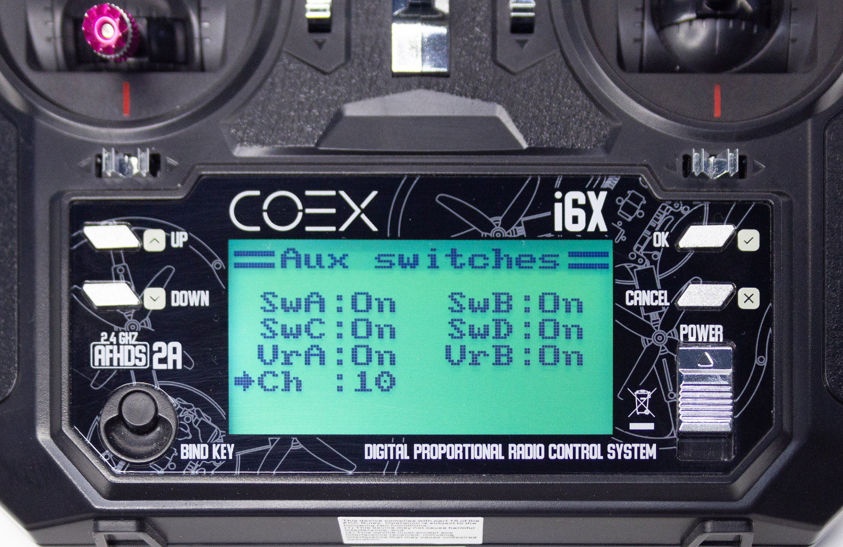
[picture p58: docs/img/rc/rc_aux_10.jpg]

>**ВНИМАНИЕ** Сохранение настроек производится с помощью долгого нажатия на клавишу CANCEL. Если просто нажать на эту клавишу, настройки сохранены не будут

Сохраните настройки, вы попадете в предыдущее меню:
_image
Еще раз нажмите клавишу CANCEL:
_image
При помощи клавиш UP и DOWN выберите пункт setup:
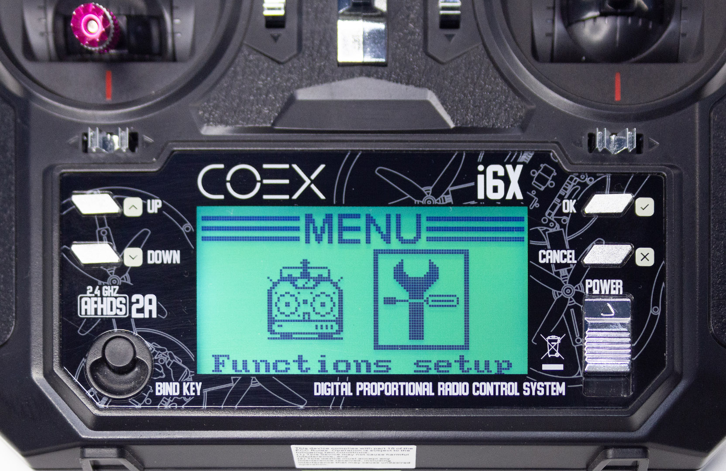
[picture p59: docs/img/rc/rc_setup.jpg]

Нажмите OK, вы попадете в меню настройки функций:
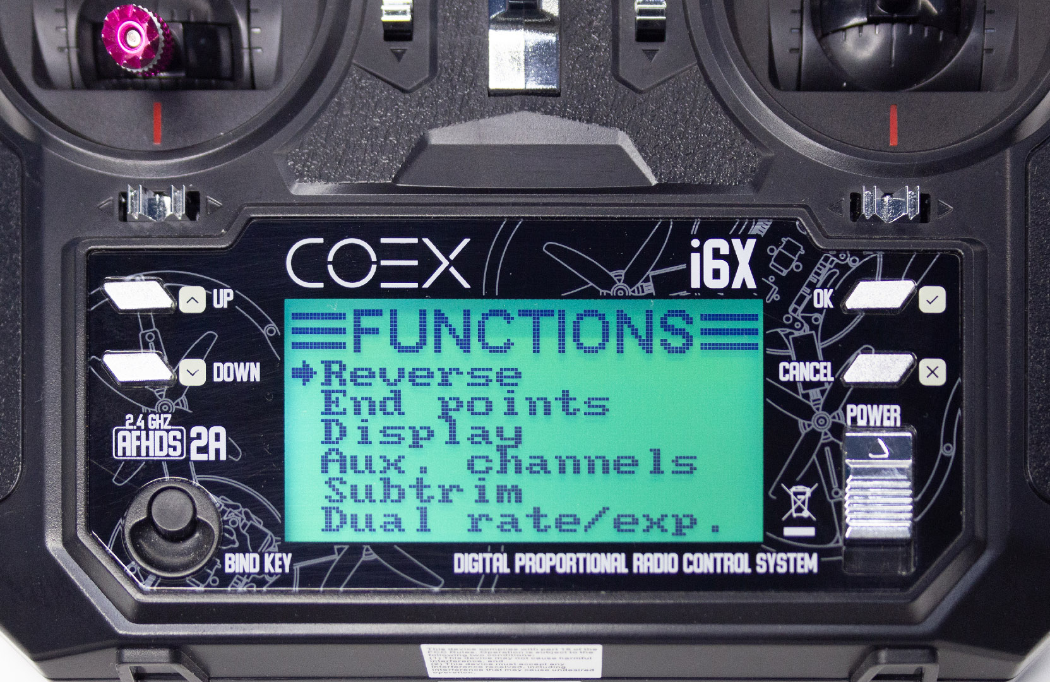
[picture p60: docs/img/rc/rc_functions.jpg]

Клавишей DOWN выберите пункт Aux. channels:
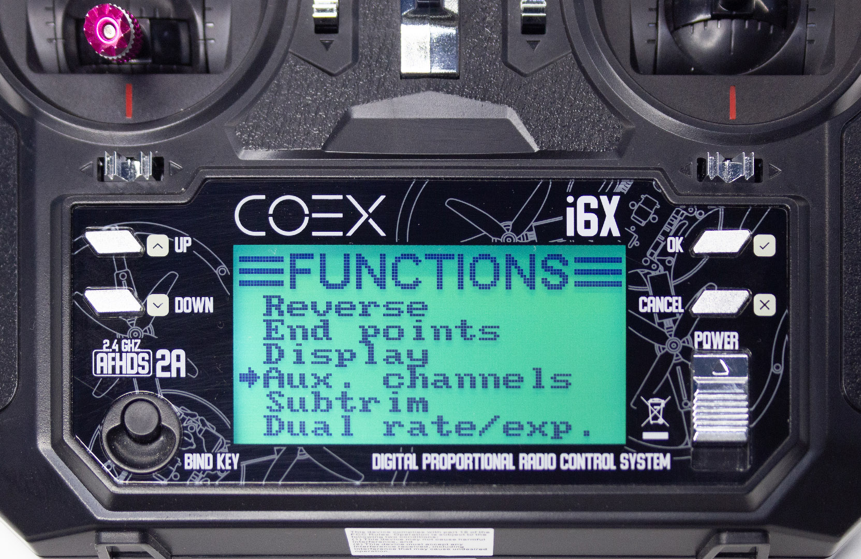
[picture p61: docs/img/rc/rc_aux_channels.jpg]

Нажмите OK, вы попадете в меню настройки дополнительных каналов. По умолчанию оно выглядит так:
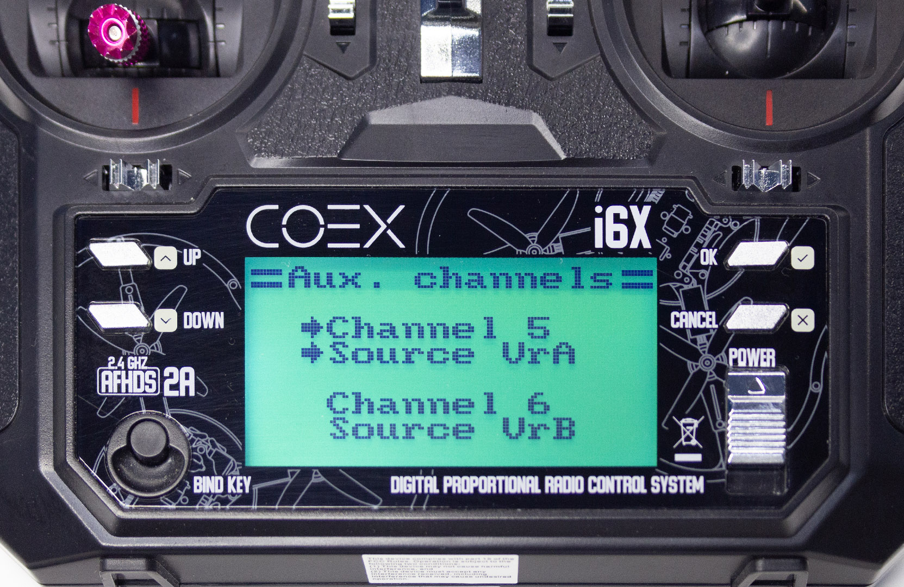
[picture p62: docs/img/rc/rc_aux_0.jpg]

При помощи клавиш UP и DOWN установите переключатели SwD, SwC, SwB, SwA в соответствие каналам 5, 6, 7, 8. Переключение между пунктами меню происходит при помощи клавиши OK. В конечном итоге пункты меню должны выглядеть таким образом:
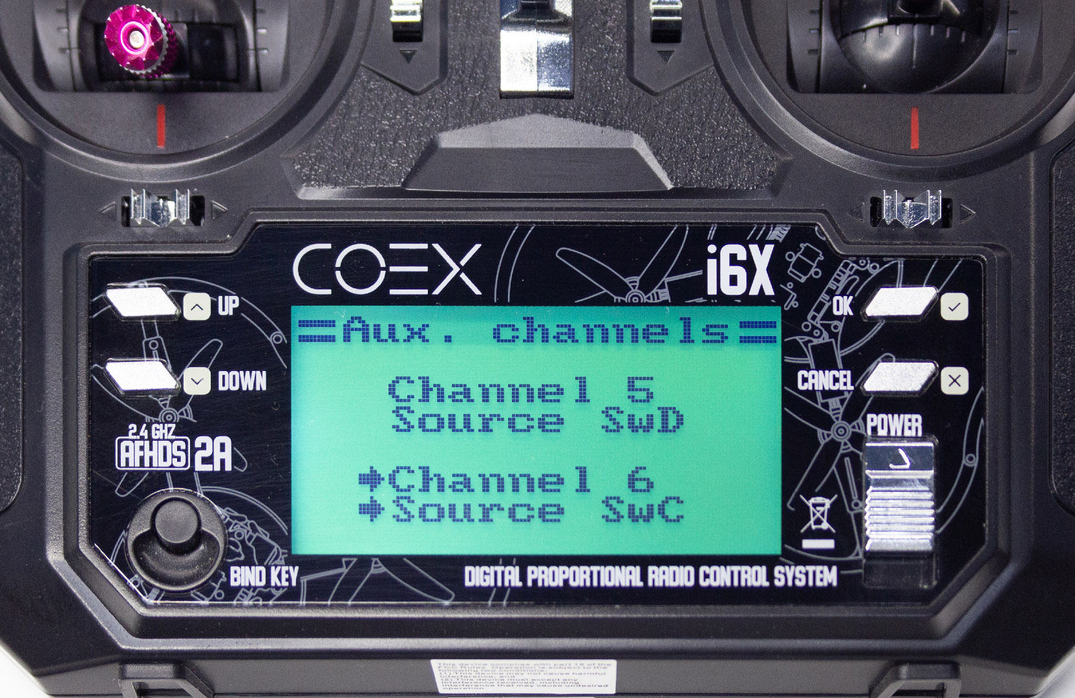
[picture p63: docs/img/rc/rc_aux_1.jpg]

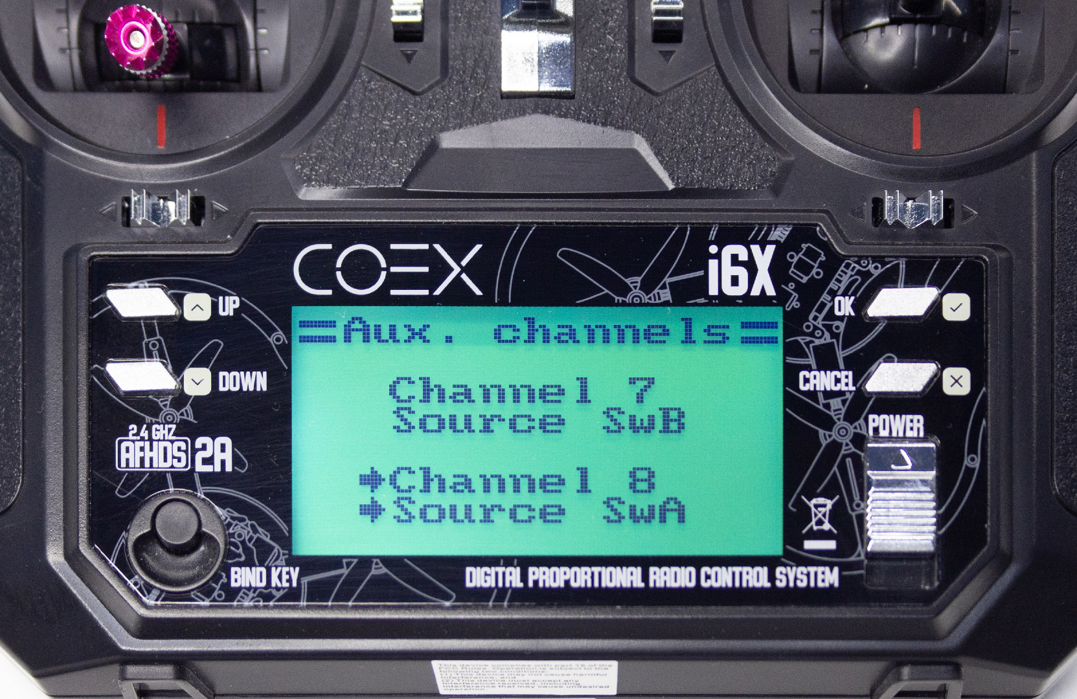
[picture p64: docs/img/rc/rc_aux_2.jpg]

Сохраните настройки долгим нажатием на клавишу CANCEL.

На этом настройка пульта закончена, вы можете переходить к настройке полетного контроллера.
