stinger000/RaceMini_docs/docs/img/belt.jpg

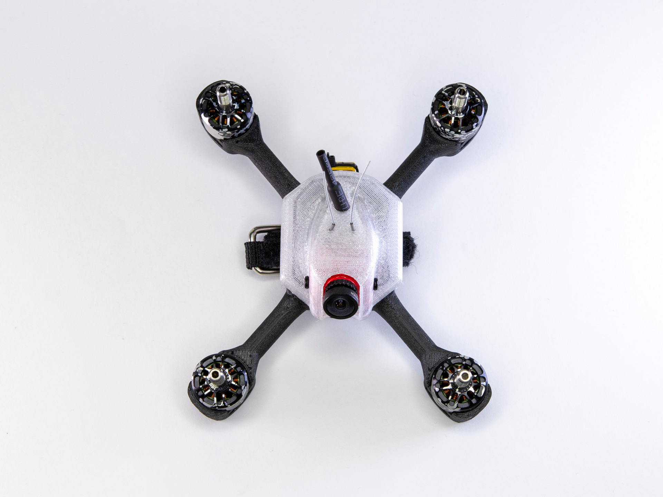
docs/img/belt.jpg
