stinger000/RaceMini_docs/docs/img/cam_cable.jpg

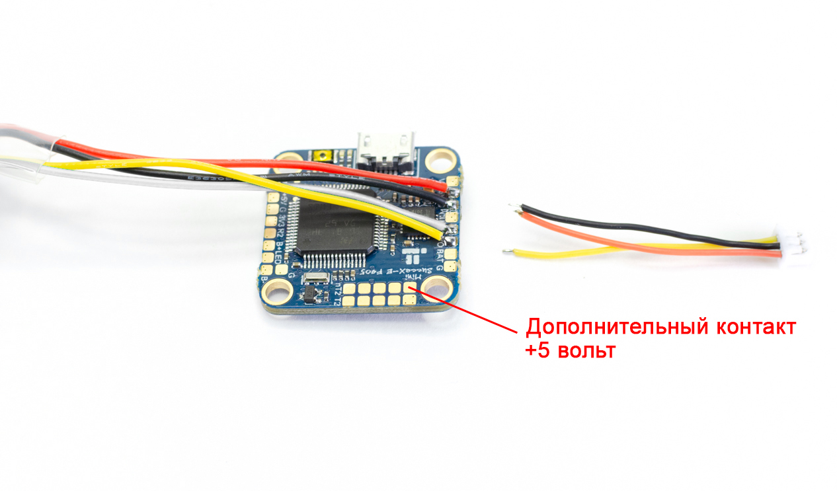
docs/img/cam_cable.jpg
