stinger000/RaceMini_docs/docs/img/esc_bolts.jpg

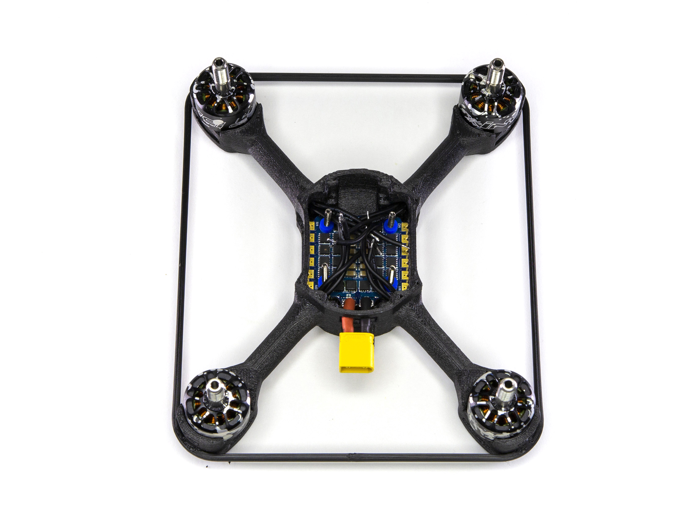
docs/img/esc_bolts.jpg
