stinger000/RaceMini_docs/docs/img/fc_cable.jpg

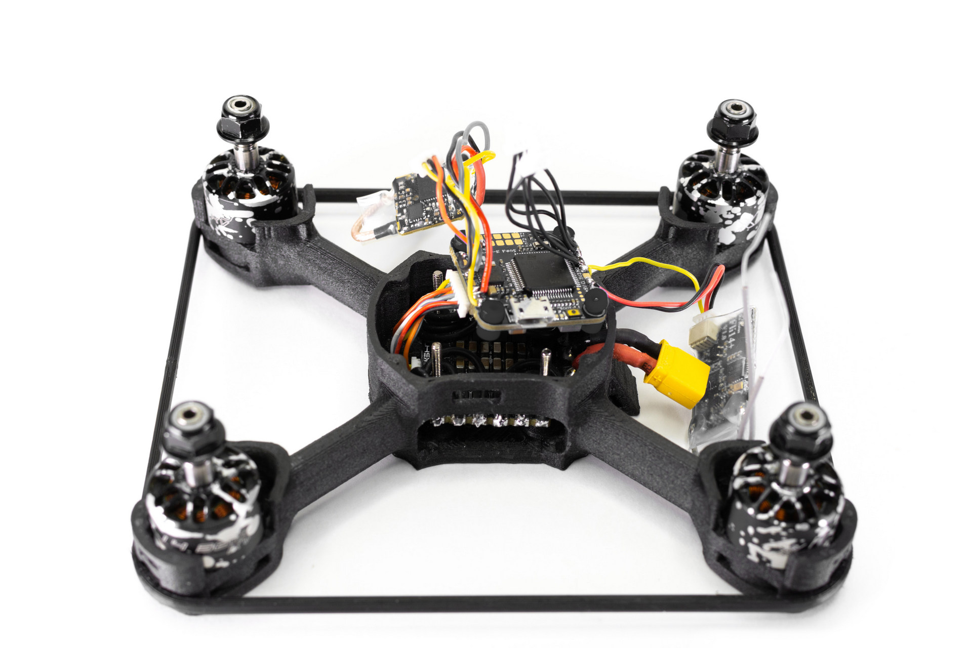
docs/img/fc_cable.jpg
