stinger000/RaceMini_docs/docs/img/fc_oring.jpg

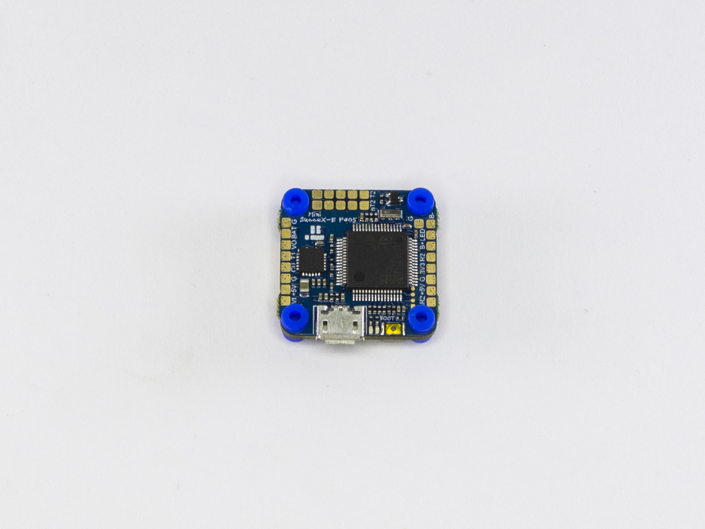
docs/img/fc_oring.jpg
