stinger000/RaceMini_docs/docs/img/final1.jpg

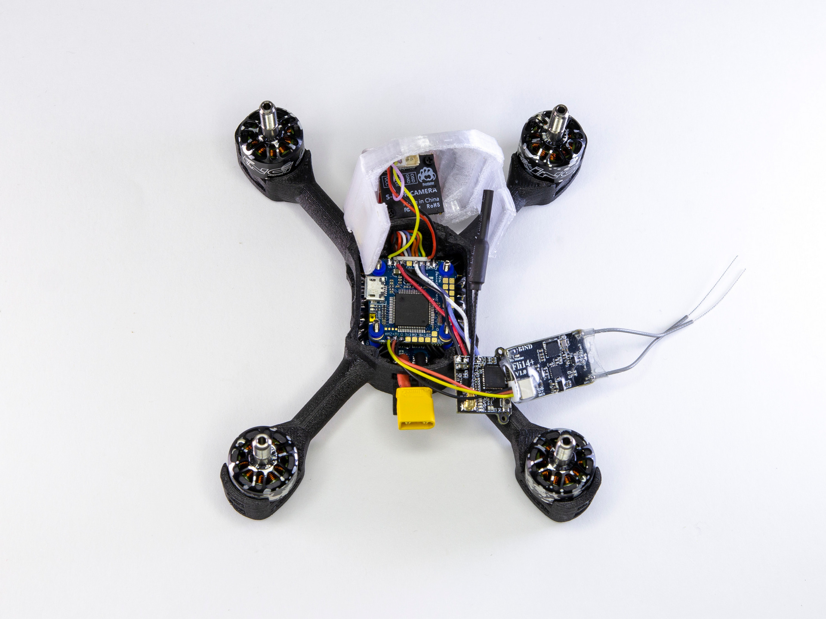
docs/img/final1.jpg
