stinger000/RaceMini_docs/docs/img/final2.jpg

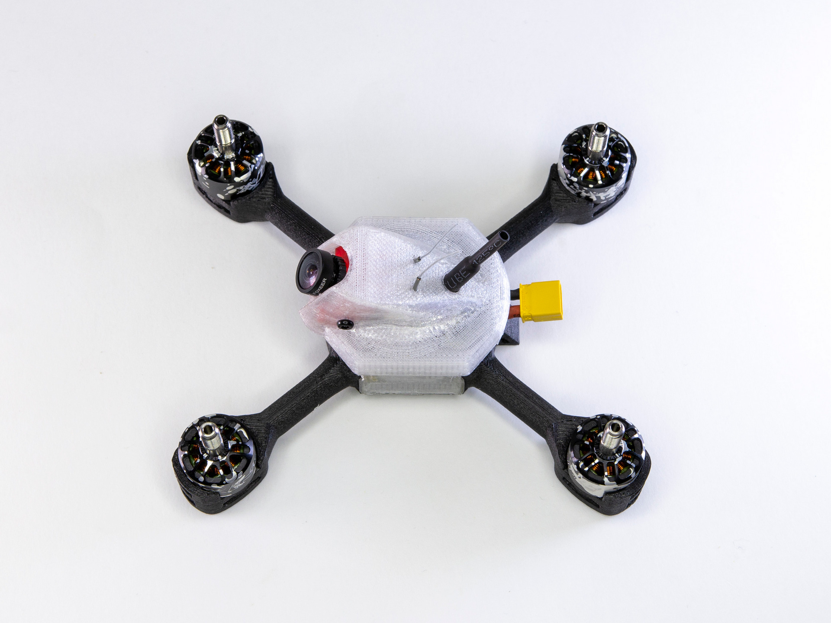
docs/img/final2.jpg
