stinger000/RaceMini_docs/docs/img/led_plugged.jpg

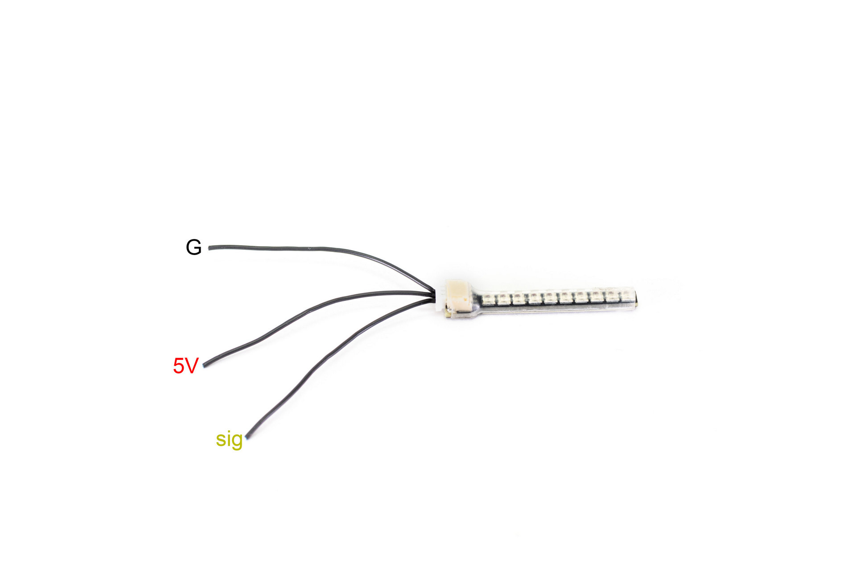
docs/img/led_plugged.jpg
