stinger000/RaceMini_docs/docs/img/led_to_fc.jpg

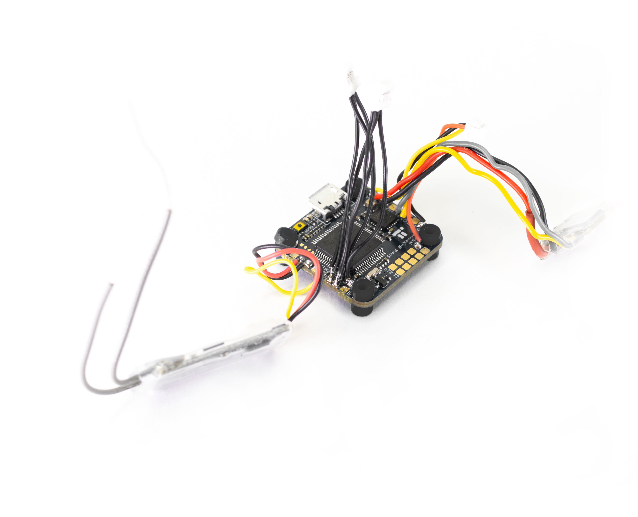
docs/img/led_to_fc.jpg
