stinger000/RaceMini_docs/docs/img/pad1.jpg

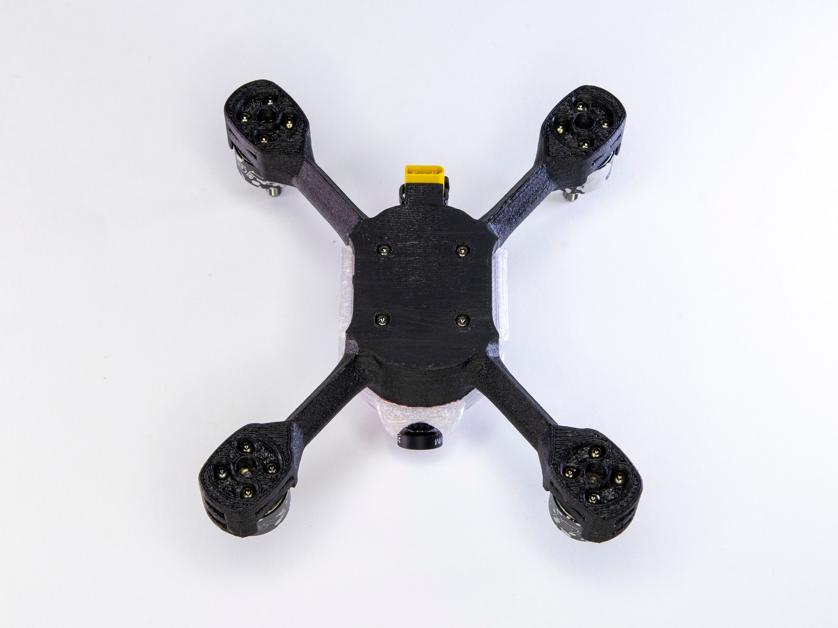
docs/img/pad1.jpg
