stinger000/RaceMini_docs/docs/img/pad2.jpg

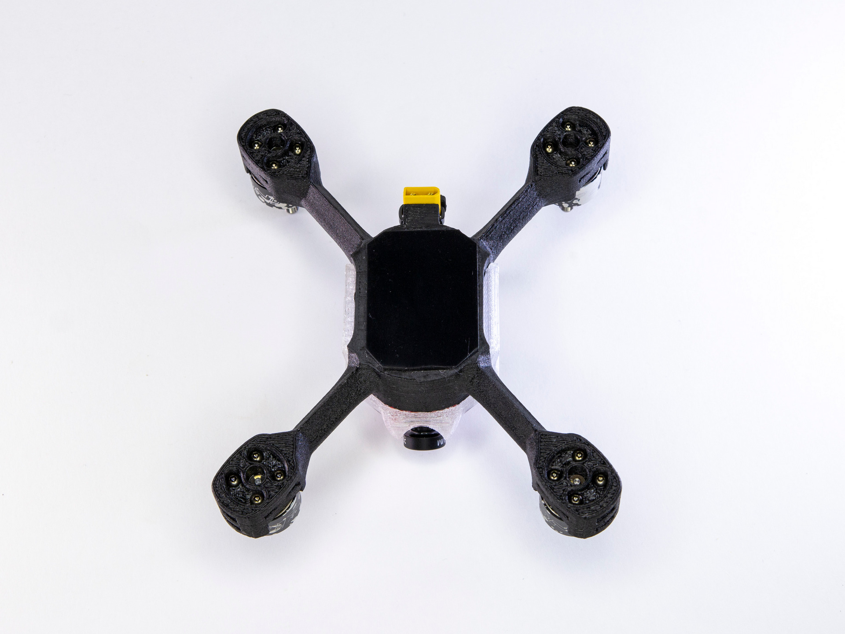
docs/img/pad2.jpg
