stinger000/RaceMini_docs/docs/img/props.jpg

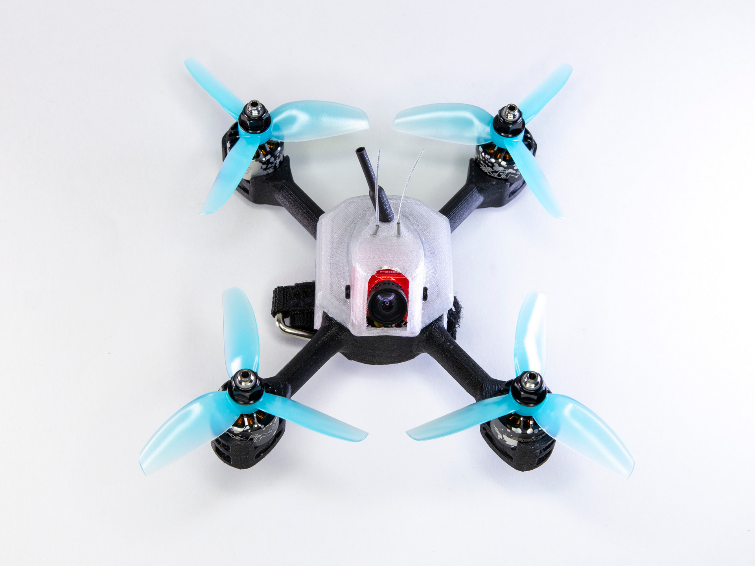
docs/img/props.jpg
