stinger000/RaceMini_docs/docs/img/rc_placed.jpg

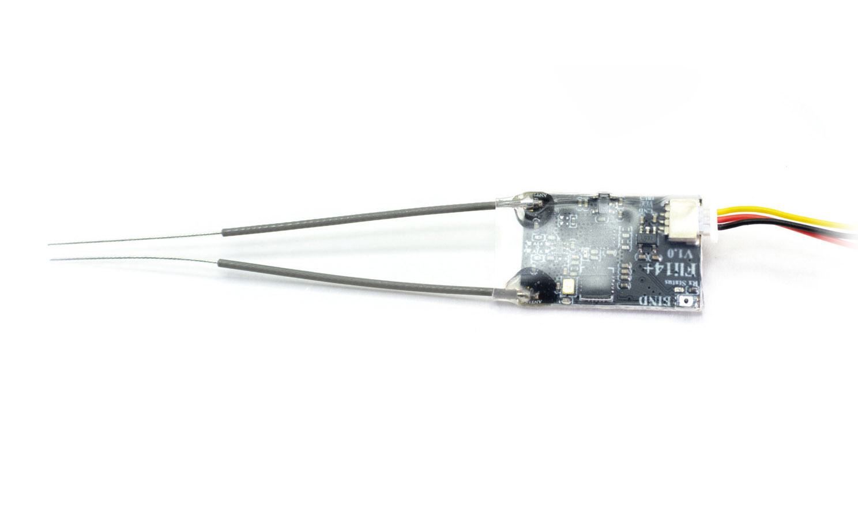
docs/img/rc_placed.jpg
