stinger000/RaceMini_docs/docs/img/rx_unbinded.webp

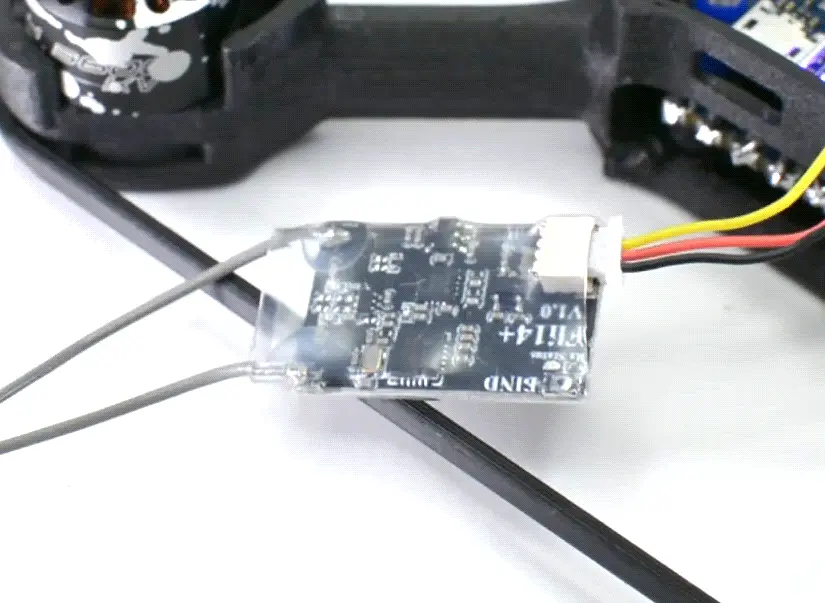
docs/img/rx_unbinded.webp
