stinger000/RaceMini_docs/docs/img/vtx.jpg

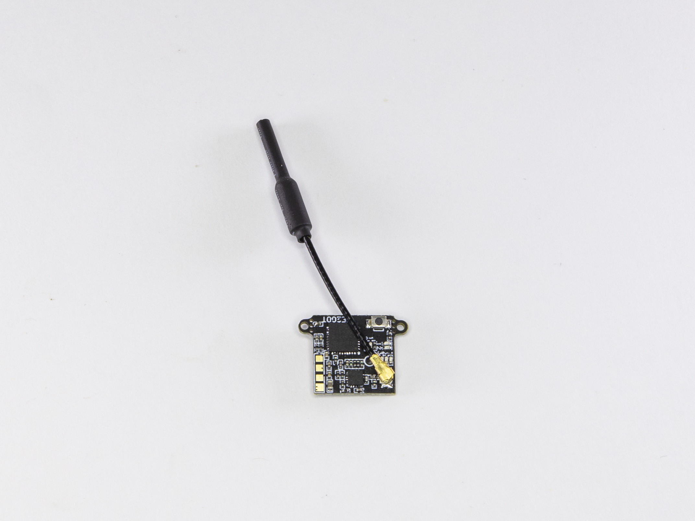
docs/img/vtx.jpg
