stinger000/RaceMini_docs/docs/res/OPEN frame 130mm v37.STL

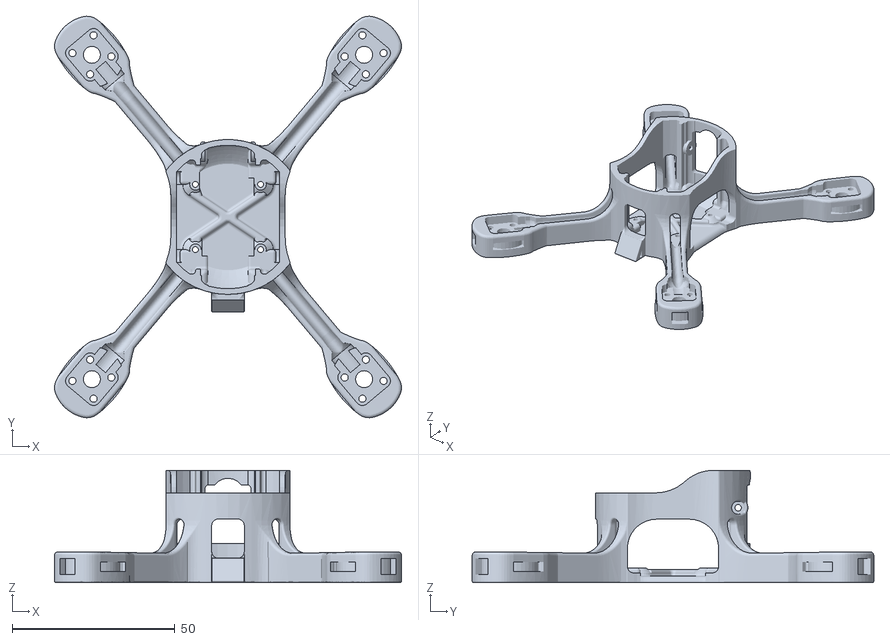
[picture p80: CAD file, 2021-05-28]
docs/res/OPEN frame 130mm v37.STL
106.5 x 123.3 x 34.5
