stinger000/RaceMini_docs/docs/res/OPEN frame TOP 130mm v34_04.STL

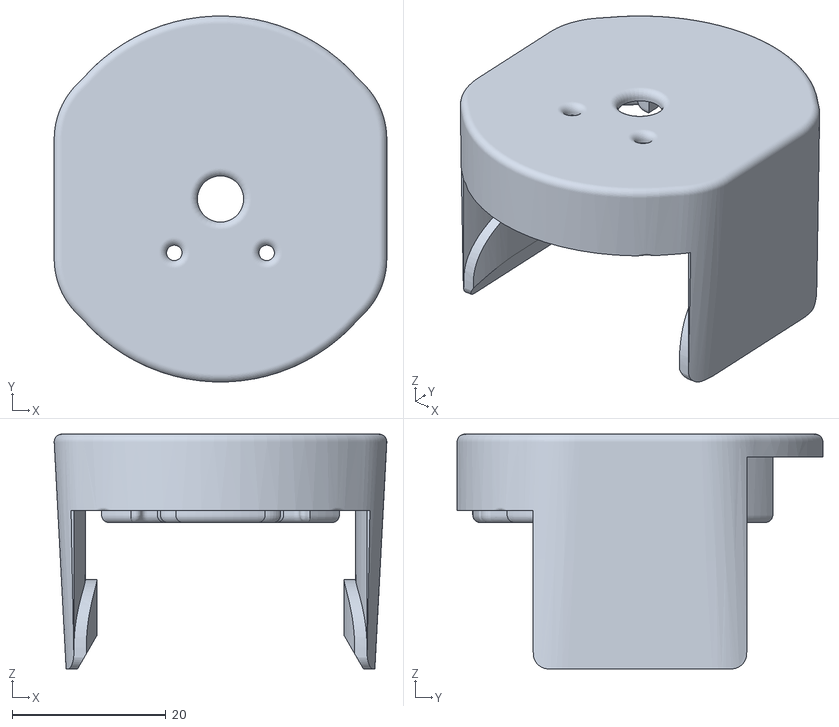
[picture p81: CAD file, 2021-04-02]
docs/res/OPEN frame TOP 130mm v34_04.STL
43.2 x 47.5 x 30.5
