stinger000/RaceMini_docs/docs/assembly_index.md

# Сборка гоночного дрона COEX Race Mini

_image

COEX Race Mini - дрон который предназначен для гонок! При помощи него вы с легкостью освоите спортивное пилотирование.
Тренируйтесь и побеждайте! Увидимся на соревнованиях!

## Инструкция по сборке

Ниже представлены инструкции по сборке дрона для различных комплектов поставки:

Внешний вид полетного контроллера | Инструкция по сборке 
:----------- |:-------------:
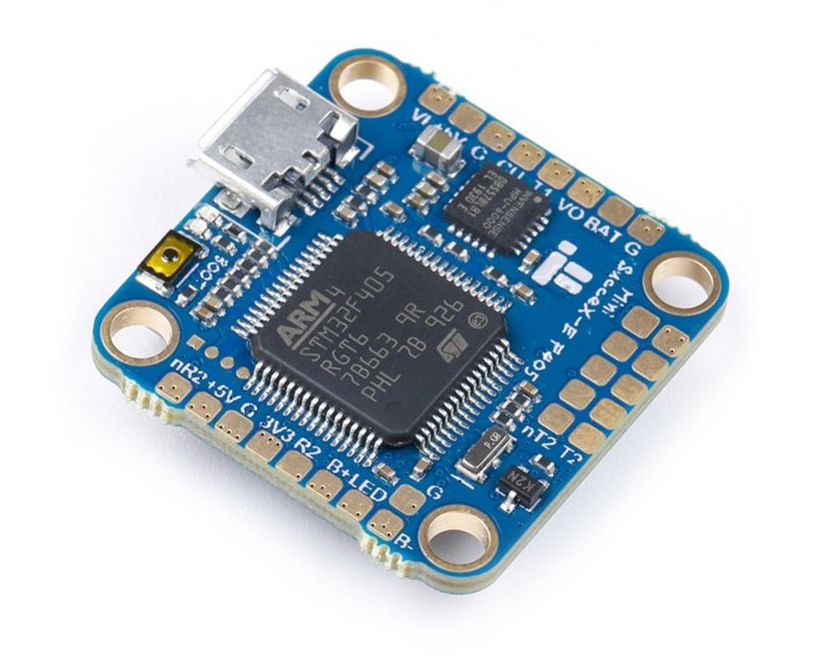
[picture p82: docs/img/fc_iflight.jpg]
        | [Полетный контроллер iflight](../assembly_iflight)        
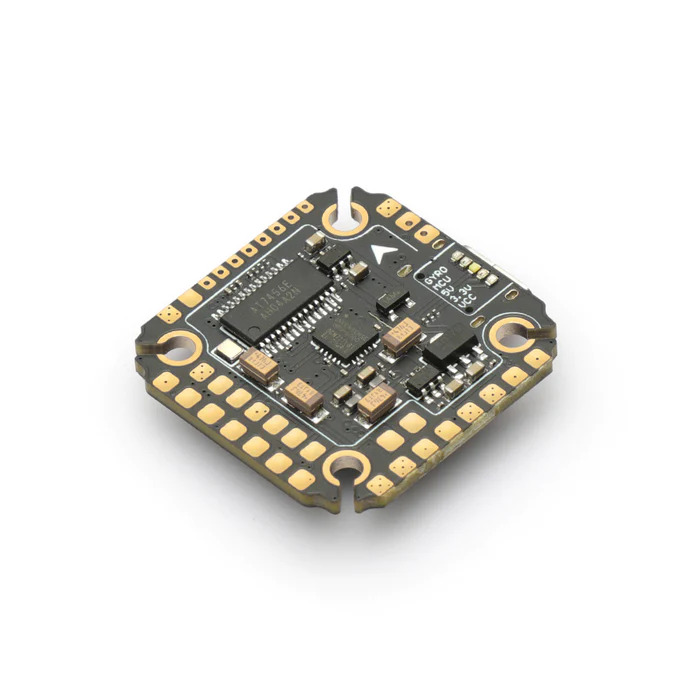
[picture p83: docs/img/fc_mamba.jpg]
          | [Полетный контроллер mamba mk3](../assembly_mamba)
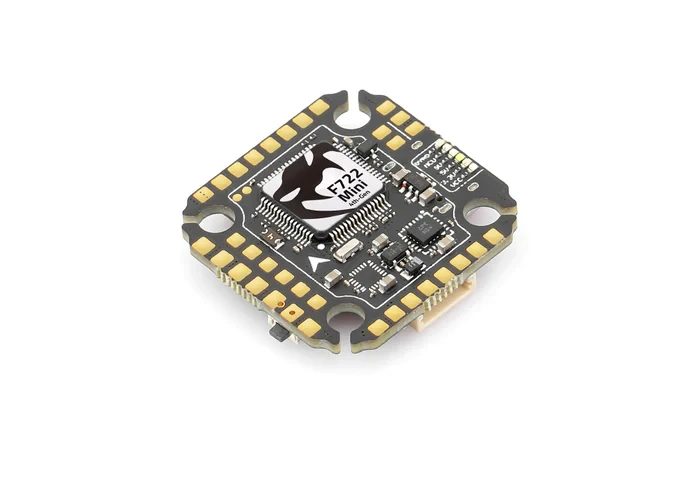
[picture p84: docs/img/fc_mamba_mk4.webp]
          | [Полетный контроллер mamba mk4](../assembly_mamba_mk4)
