stinger000/RaceMini_docs/docs/assembly_mamba_mk4.md

# Сборка гоночного дрона COEX Race Mini

## Комплект поставки
Внешний вид коробки:
_image
Содержимое:
_image

## Установка моторов
Установите ребро жесткости на раму, как это показано на видео:
<video src="../video/hack.mp4" controls width="100%" ></video>
Изначально моторы поставляются с проводами одинаковой длины и гайками правого вращения:
_image
Два мотора (они будут вращаться по часовой стрелке) обрежьте как показано на рисунке: нижний провод должен быть длиной 60 миллиметров, обозначим его буквой <span style="color:lime">А</span>; средний провод должен быть длиной 65 миллиметров, обозначим его буквой <span style="color:blue">В</span>; верхний провод должен быть длиной 70 миллиметров, обозначим его буквой <span style="color:red">С</span>.
_image
Другие два мотора (они будут вращаться против часовой стрелки) обрежьте как показано на другом рисунке:
_image
Снимите 3 миллиметра изоляции с каждого провода и залудите их. Расположение моторов на дроне будет следующим: моторы, вращающиеся против часовой стрелки находятся на местах 1 и 4, моторы, вращающиеся по часовой стрелке располагаются на местах 2 и 3. На данном рисунке направление переда рамы обозначено стрелкой.
_image
Установите моторы на места и закрепите с обратной стороны рамы, используя винты М2 из набора моторов:
_image
_image

## Установка ESC
Подключение ESC аналогично iflight.
Обрежьте кабель питания до длины в 20 миллиметров:
_image
Снимите три миллиметра изоляции и залудите провода:
_image
Припаяйте их к плате, соблюдая полярность: красный провод необходимо подключить к контакту, обозначенному знаком +, а черный - к контакту, обозначенному знаком - :
_image
Установите силиконовые проставки в отверстия:
_image
Более длинная часть должна быть направлена вверх:
_image
Вставьте шлейф в плату регуляторов:
_image
Установите плату регуляторов со шлейфом в корпус, закрутите винтами М2x20 с обратной стороны.
_image
Припаяйте выводы моторов к контактным площадкам: на рисунке ниже буква
<span style="color:lime">А</span>
соответствует короткому проводу, буква
<span style="color:blue">В</span> -
среднему, а буква
<span style="color:red">С</span> -
длинному проводу.
_image
Вид сбоку:
_image

## Установка полетного контроллера

Внешний вид полетного контроллера:
_image

### Подключение видеопередатчика
Для видеопередатчика IFlight воспользуйтесь данной инструкцией. Если в комплекте с дроном идет видеопередатчик Mamba, то
шаги инструкции будут те же, но расположение выводов видеопередатчика будет отличаться:

<details>
  <summary>Подключение Mamba VTX</summary>
Данный видеопередатчик имеет следующее расположение выводов:
описание 
Он подключается в следующей последовательности:
   <table>
        <tr><th>VTX</th><th>Полетный контроллер</th></tr>
        <tr>
             <td>
                  <font color=red>5V</font>
             </td>
             <td>5v</td>
        </tr>
        <tr>
             <td><font color=black>GND</font></td>
             <td>GND</td>
        </tr>
        <tr>
             <td><font color=goldenrod>VTX</font></td>
             <td>VTX</td>
        </tr>
        <tr>
             <td><font class="outlined">DATA</font> </td>
             <td>TX3</td>
        </tr>
   </table>

</details>

Видеопередатчик находится внутри этой коробочки:
_image
Внутри находится сам видеопередатчик, адаптер для установки в отверстия 20х20 (он нам не понадобится), антенна, переходник для установки другой антенны (он также не понадобится) и провода:
_image
На верхней стороне видеопередатчика находятся подписи контактных площадок:
_image
С другой стороны располагается разъем для антенны и кнопка переключения каналов:
_image
Припаяйте провода к видеопередатчику в следующей последовательности:
<span style="color:red">красный</span>
провод к контакту +5V, **черный** - к контакту GND,
<span style="color:goldenrod;">желтый</span> - к контакту VIDEO и
<span class="outlined">белый</span> - к контакту RX:
_image
Вставите антенну в видеопередатчик:
_image
Наденьте термоусадку на видеопередатчик и усадите её потоком горячего воздуха:
_image
Обрежьте провода до длины в 60 миллиметров, залудите на 3 миллиметра и припаяйте провода к полетному контроллеру в следующей последовательности:
<span style="color:red">красный</span>
провод к контакту 5V, **черный** - к контакту GND,
<span style="color:goldenrod;">желтый</span> - к контакту VTX и
<span class="outlined">белый</span> - к контакту TX3:
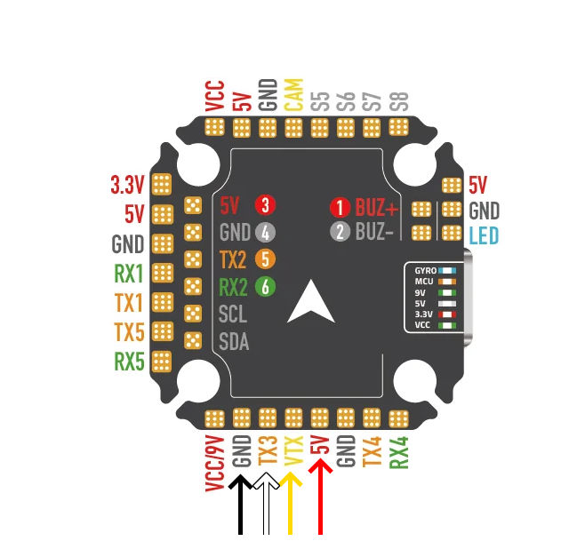
[picture p85: docs/img/mamba_mk4/vtx_pads.jpg]


### Подключение камеры

Внешний вид камеры:
_image
Обрежьте ответный кабель разъема камеры на длину в 50 миллиметров, и залудите концы на длину в 3 миллиметра. Припаяйте его к полетному контроллеру в следующем порядке:
**черный** провод - к контакту GND,
<span style="color:goldenrod;">желтый</span> - к контакту CAM,
<span style="color:red">красный</span> - к контакту 5V, как показано на схеме:
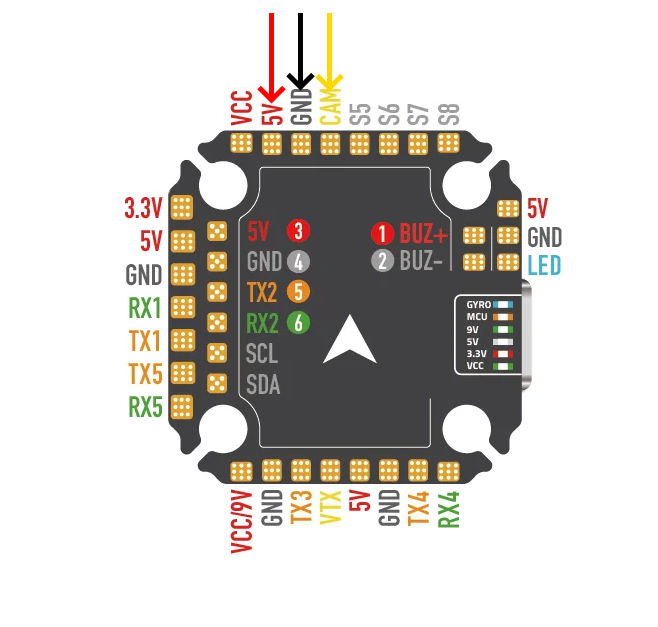
[picture p86: docs/img/mamba_mk4/cam_pads.jpg]


### Подключение светодиодной ленты

В комплекте со светодиодной лентой идет провод:
_image
Припаяйте провода к полетному контроллеру в следующей последовательности:
**черный** к контакту GND,
<span style="color:red">красный</span> к контакту 5V полетного контроллера, и
<span style="color:goldenrod;">желтый</span> к контакту LED, как показано на схеме:
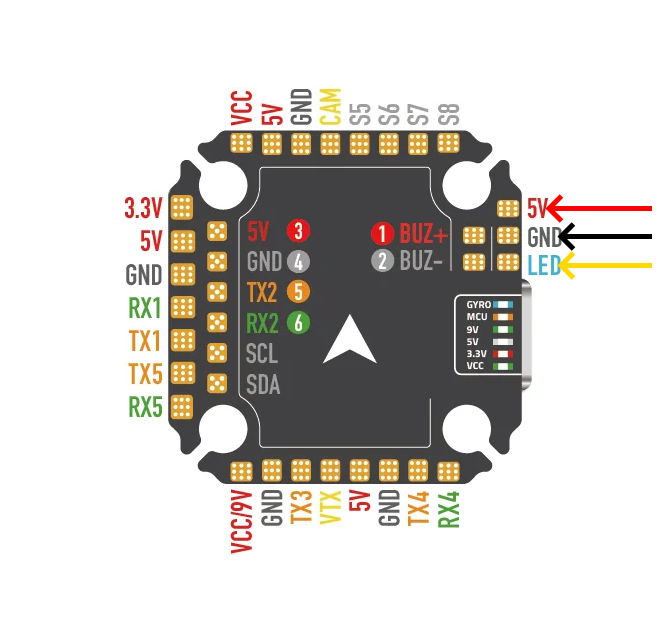
[picture p87: docs/img/mamba_mk4/led_pads.jpg]


### Подключение радиоприемника

Внешний вид радиоприемника:
_image
Обрежьте провода приемника на длину 50 миллиметров и залудите концы на длину 3 миллиметра. Припаяйте провода к полетному контроллеру в следующем порядке:
<span style="color:red">красный</span>
провод к контакту +5V, **черный** - к контакту G,
<span style="color:goldenrod;">желтый</span> - к контакту RX1, как показано на рисунке:
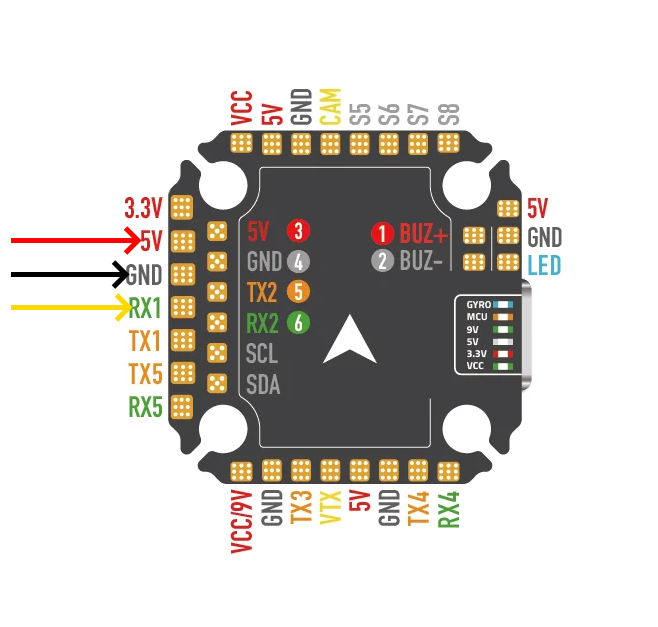
[picture p88: docs/img/mamba_mk4/rc_pads.jpg]

Наденьте термоусадку на радиоприемник и усадите:
_image
После этого подключите приемник к припаянному только что кабелю.

### Установка полетного контроллера в корпус
Вставьте силиконовые проставки в полетный контроллер в соответствие со схемой:
_image
Подключите шлейф, идущий от регуляторов к полетному контроллеру, установите его в корпус и зафиксируйте гайками:
_image
_image

## Подключение аппаратуры радиоуправления

Если сейчас подключить аккумулятор к дрону, то светодиод на приемнике начнет медленно мигать:
<picture>
   <source srcset="/img/rx_unbinded.avif" type="image/avif">
   <source srcset="/img/rx_unbinded.webp" type="image/webp">
   описание
</picture>
Это означает, что радиоприемник не получает сигнал от аппаратуры радиоуправления. Такое может происходить в двух случаях:

1. Аппаратура радиоуправления выключена
2. Радиоприемник и аппаратура радиоуправления не настроены для работы друг с другом

Для радиоуправления дроном необходимо настроить радиоприемник на работу с конкретной радиоаппаратурой (данная процедура называется bind). Для этого необходимо при выключенном питании дрона нажать кнопку Bind на радиоприемнике, после чего с зажатой кнопкой подключить аккумулятор. Светодиод на радиоприемнике начнет быстро мигать:
<picture>
   <source srcset="/img/rx_binding.avif" type="image/avif">
   <source srcset="/img/rx_binding.webp" type="image/webp">
   описание
</picture>

После этого зажмите кнопку Bind на аппаратуре управления и включите ее:
_image
В случает успеха светодиод на радиоприемнике будет гореть постоянно:
_image
А на экране аппаратуры радиоуправления будет отображаться напряжение питания приемника:
_image
## Финальная сборка

Внешний вид канопы с камерой:
_image
Установите камеру внутри канопы и зафиксируйте винтами:
_image
Подключите камеру к полетному контроллеру. Расположите радиоприемник и видеопередатчик внутри канопы. Проденьте разъемы для светодиодных лент в отверстия канопы и подключите их.
_image
Защелкните светодиодные ленты в их посадочных местах:
_image
Подключите переходник USB и выполните
[настройку дрона](setup):
_image
После того, как настройка закончена, защелкните канопу на дроне:
_image
Переверните дрон нижней стороной вверх:
_image
Наклейте противоскользящую накладку:
_image
На этом сборка завершена.
