stinger000/RaceMini_docs/(commit log)

2021-02-23 fixed biard name in setup.md
    [dump.txt]
2021-02-24 changed wire color
2021-03-30 fixed board name in setup.md
    [dump.txt]
2021-04-02 add 3d printing page
    [OPEN frame 130mm v36.STL, OPEN frame TOP 130mm v34_04.STL]
2021-05-28 update frame
    [OPEN frame 130mm v36.STL, OPEN frame 130mm v37.STL]
2021-05-30 new led cable and fc
